researchanddesire/OSSM/README.md

# OSSM

A fresh home for the Research and Desire OSSM hardware designs.

The starting design is Lucy Chapar's motor control harness. Mechanical CAD and
PCB designs will be added as they are developed and reviewed. There is no
complete machine design or firmware release in this baseline.

To build an OSSM, follow the [build guides](hardware/build-guides/).

## Repository layout

| Folder | Contents |
| --- | --- |
| [`hardware/cables/`](hardware/cables/) | Motor control harness source and reference images |
| [`hardware/cad/`](hardware/cad/) | New mechanical design sources and STEP exports |
| [`hardware/pcb/`](hardware/pcb/) | New PCB projects, schematics, and local libraries |
| [`hardware/build-guides/`](hardware/build-guides/) | PDF build guides for the stand, actuator, wiring and wired remote |
| [`assembly-docs/`](assembly-docs/) | Assembly documentation developed alongside these designs |
| [`software/firmware/`](software/firmware/) | PlatformIO firmware project |
| [`software/scripts/`](software/scripts/) | Release, screen capture, rig and cable rendering tooling |
| [`software/dev/`](software/dev/) | Local development services |

## Render the cable

Install Python 3 and Graphviz, then run:

```sh
python3 -m venv .venv
. .venv/bin/activate
python -m pip install -r software/scripts/requirements-cables.txt
bash software/scripts/render-cables.sh
```

The command writes the diagram, PDF, HTML, and cable BOM to `cable-export/`.
CI updates the diagram shown in [`hardware/cables/README.md`](hardware/cables/README.md).
PDF, SVG, HTML, and detailed cable BOM exports are available from the
[Render Cable Harnesses workflow](https://github.com/researchanddesire/OSSM/actions/workflows/render-cables.yml).

## License

Hardware designs use [CERN-OHL-S v2](LICENSES/CERN-OHL-S-2.0.txt).
