researchanddesire/OSSM/hardware/cad/README.md

# OSSM CAD

STEP component exports for the parts in [the hardware BOM](../bom.csv).

- `actuator/`: body, belt clamps, tensioner and jam nut.
- `stand/`: PCB enclosure, PitClamp components, pivot plates, handle spacer, feet and extrusion end caps.

Most STEP files use millimetres; the PCB mount base and lid use metres.
Pivot plate 1 is the right plate; plate 2 is the left plate.
The upper-and-handle BOM entry links to both component files.
