researchanddesire/OSSM/hardware/pcb/README.md

# PCB design

New OSSM PCB projects belong here. No PCB design has been added to this rebuild
yet.

Keep editable schematics and board files with their project-local libraries and
models. Record the design application and revision. Add fabrication exports
only for the corresponding reviewed board revision.
