researchanddesire/OSSM/hardware/cad/remote/README.md

# Wired remote

| Part | Quantity per remote | STEP model |
| --- | ---: | --- |
| Body | 1 | [body.step](body.step) |
| Top cover | 1 | – |
| Knob | 2 | [knob.step](knob.step) |

These are the printed components of the complete wired remote assembly in the
[product BOM](../../bom.csv). Its Ethernet cable and two M4x8 screws are already
listed as included accessories. The [remote PCB source](../../pcb/remote/remote.sch)
is separate.
