researchanddesire/OSSM/hardware/cad/stand/README.md

# PitClamp upper and handle

The BOM's “PitClamp v1.1 Upper + Handle” entry contains one of each:

- [Upper v1.1](pitclamp-upper-v1.1.step)
- [Handle](pitclamp-handle.step)
