researchanddesire/OSSM/developer-docs/docs/hardware/specs.md

# OSSM Specs

Here you'll find an overview of the OSSM's device specifications.

## Performance

- Maximum linear speed - 1m/s
- Maximum strokes per minute - 165
- Maximum push force - 20kg
- Maximum toy weight - 1.1kg

## Dimensions

- Collapsed - 56x29x16cm
- Upright - 56x29x58cm
- Stroke length - 18cm
- Rail length - 35cm

## Electrical

- Operating voltage - 24V DC
- Current draw - 4A
- Idle power - 1-5W
- Average power - 30W
- Peak power - 95W

!!! warning "We caution against using third party power supplies as their use may short the OSSM board, thus rendering the OSSM unusable, or provide insufficient operating power."

## Motor

- Speed rating - 1500rpm
- Interface - RS485
- Model - 57AIM30
