researchanddesire/OSSM/developer-docs/docs/architecture/state-machine.md

---
title: "State Machine"
description: "Understanding the OSSM firmware state machine architecture"
---

import { MermaidControls } from '/snippets/shared/mermaid-controls.jsx';

# State Machine Architecture

The OSSM firmware uses a declarative state machine to manage device behavior. This ensures predictable transitions between operating modes and prevents invalid states that could cause unexpected behavior.

## State Diagram

The following diagram shows all states and transitions in the OSSM state machine:

```mermaid
stateDiagram-v2
    direction TB

    [*] --> idle
    idle --> homing : done

    state homing {
        direction LR
        forward --> backward : done
        forward --> [*] : error
        backward --> [*] : error
    }

    homing --> menu : homed
    homing --> error : failed

    state menu {
        direction LR
        [*] --> selecting
    }

    menu --> simplePenetration : select
    menu --> strokeEngine : select
    menu --> streaming : select  
    menu --> update : select
    menu --> wifi : select
    menu --> help : select
    menu --> restart : select

    state simplePenetration {
        direction LR
        [*] --> sp_preflight
        sp_preflight --> sp_playing : done
    }
    simplePenetration --> homing : not homed
    simplePenetration --> menu : longPress

    state strokeEngine {
        direction LR
        [*] --> se_preflight
        se_preflight --> se_playing : done
        se_playing --> se_pattern : doublePress
        se_pattern --> se_playing : buttonPress
        se_playing --> se_playing : buttonPress
    }
    strokeEngine --> homing : not homed
    strokeEngine --> menu : longPress

    state streaming {
        direction LR
        [*] --> st_preflight
        st_preflight --> st_playing : done
    }
    streaming --> homing : not homed
    streaming --> menu : longPress

    state update {
        direction LR
        [*] --> checking
        checking --> updating : available
        checking --> noUpdate : current
        noUpdate --> [*] : buttonPress
        updating --> [*] : complete
    }
    update --> wifi : offline
    update --> menu : buttonPress

    state wifi {
        direction LR
        [*] --> portal
    }
    wifi --> menu : done
    wifi --> restart : longPress

    state help {
        [*] --> helpScreen
    }
    help --> menu : buttonPress

    state error {
        direction LR
        [*] --> errorScreen
        errorScreen --> errorHelp : buttonPress
        errorHelp --> [*] : buttonPress
    }

    restart --> [*]
```

## Design Overview

The state machine is implemented using [Boost.SML](https://boost-ext.github.io/sml/) (State Machine Language), a header-only C++14 library that provides a domain-specific language for defining state machines.

### Why Boost.SML?

Boost.SML was chosen for OSSM because it offers:

- **Compile-time verification** - Invalid transitions are caught at compile time, not runtime
- **Zero runtime overhead** - Performance equivalent to hand-written switch/case
- **Declarative syntax** - The transition table reads like documentation
- **Thread safety** - Built-in support for concurrent access via policies
- **Small footprint** - Single header, ~2000 lines of code, no dependencies

### Transition Table Syntax

Each row in the transition table follows this pattern:

```cpp
source_state + event [guard] / action = target_state
```

For example:

```cpp
"menu.idle"_s + buttonPress[(isOption(Menu::SimplePenetration))] = "simplePenetration"_s
```

This reads as: "When in `menu.idle` state and a `buttonPress` event occurs, if the guard `isOption(Menu::SimplePenetration)` returns true, transition to `simplePenetration` state."

!!! info
    For a complete tutorial on transition table syntax, see the [Boost.SML Tutorial](https://boost-ext.github.io/sml/tutorial.html).

## Events

Events trigger state transitions. They are simple structs defined in `Events.h` and can be dispatched from anywhere in the codebase.

| Event | Description | Typical Source |
|---|---|---|
| `ButtonPress` | Single button click | Rotary encoder button |
| `LongPress` | Button held for extended duration | Rotary encoder button (held) |
| `DoublePress` | Two rapid button clicks | Rotary encoder button |
| `Done` | Async operation completed | Homing task, preflight check |
| `Error` | Operation failed | Homing failure, stroke too short |
| `EmergencyStop` | Immediate halt required | Safety systems |
| `Home` | Request homing sequence | External command |

### Dispatching Events

Events are dispatched using the global `stateMachine` instance:

```cpp
#include "ossm/state/state.h"

// From anywhere in the codebase
stateMachine->process_event(ButtonPress{});
stateMachine->process_event(Done{});
```

The state machine is initialized at startup in [`state.cpp`](https://github.com/KinkyMakers/OSSM-hardware/blob/main/Software/src/ossm/state/state.cpp) and exposed as a global pointer.

!!! tip
    Events are defined as empty structs. The type itself carries the meaning - no data payload is needed.

## Guards

Guards are conditional checks that determine whether a transition should occur. They return `true` to allow the transition or `false` to block it.

| Guard | Description | Returns `true` when... |
|---|---|---|
| `isOnline` | Check WiFi connection | Device is connected to WiFi |
| `isUpdateAvailable` | Check for firmware updates | Server reports newer version available |
| `isStrokeTooShort` | Validate homing result | Measured stroke is below minimum threshold |
| `isOption(Menu)` | Check selected menu item | Current menu selection matches the specified option |
| `isPreflightSafe` | Validate speed knob position | Speed potentiometer is in the dead zone (safe to start) |
| `isFirstHomed` | One-time initial homing check | This is the first successful homing since boot |
| `isNotHomed` | Check homing status | Device has not been homed or homing was invalidated |

### Guard Implementation

Guards are defined as `constexpr` lambdas in the [`guards`](https://github.com/KinkyMakers/OSSM-hardware/blob/main/Software/src/ossm/state/guards.h) namespace. They call forward-declared implementation functions to keep the header lightweight:

```cpp
// In guards.h - forward declaration
bool ossmIsPreflightSafe();

namespace guards {
    // Constexpr lambda wraps the implementation
    constexpr auto isPreflightSafe = []() { 
        return ossmIsPreflightSafe(); 
    };

    // Parameterized guard using nested lambda
    constexpr auto isOption = [](Menu option) {
        return [option]() { return ossmGetMenuOption() == option; };
    };
}
```

The actual logic lives in `guards.cpp`, keeping compile times fast and allowing implementation changes without recompiling the transition table.

!!! info
    For more on guard patterns, see the [Boost.SML Guards documentation](https://boost-ext.github.io/sml/user-guide.html#guards).

## Actions

Actions are functions executed during state transitions. They perform side effects like updating the display, starting motors, or resetting settings.

### Display Actions

| Action | Description |
|---|---|
| `drawHello` | Show welcome/boot screen |
| `drawMenu` | Render the main menu |
| `drawPlayControls` | Show speed/stroke/depth controls |
| `drawPatternControls` | Show pattern selection UI |
| `drawPreflight` | Show "reduce speed to start" warning |
| `drawHelp` | Display help/support information |
| `drawWiFi` | Show WiFi configuration screen |
| `drawUpdate` | Show "checking for updates" screen |
| `drawNoUpdate` | Show "firmware is up to date" message |
| `drawUpdating` | Show update progress |
| `drawError` | Display error state with message |

### Motion Actions

| Action | Description |
|---|---|
| `startHoming` | Begin the homing sequence |
| `clearHoming` | Reset homing state variables |
| `startSimplePenetration` | Start Simple Penetration mode task |
| `startStrokeEngine` | Start Stroke Engine mode task |
| `startStreaming` | Start Streaming mode task |
| `emergencyStop` | Force stop motor and disable outputs |

### Settings Actions

| Action | Description |
|---|---|
| `resetSettingsStrokeEngine` | Initialize defaults for Stroke Engine (speed=0, stroke=50, depth=10, sensation=50) |
| `resetSettingsSimplePen` | Initialize defaults for Simple Penetration (speed=0, stroke=0, depth=50) |
| `incrementControl` | Cycle through control parameters (stroke → depth → sensation) |
| `setHomed` | Mark device as successfully homed |
| `setNotHomed` | Invalidate homing (requires re-home before play) |

### System Actions

| Action | Description |
|---|---|
| `restart` | Restart the ESP32 |
| `resetWiFi` | Clear saved WiFi credentials |
| `updateOSSM` | Download and install firmware update |

### Action Implementation

Actions are defined as `constexpr` lambdas in the [`actions`](https://github.com/KinkyMakers/OSSM-hardware/blob/main/Software/src/ossm/state/actions.h) namespace. Like guards, they delegate to forward-declared implementation functions:

```cpp
// In actions.h - forward declarations
void ossmDrawHello();
void ossmEmergencyStop();

namespace actions {
    constexpr auto drawHello = []() { ossmDrawHello(); };
    constexpr auto emergencyStop = []() { ossmEmergencyStop(); };
}
```

The implementation functions in `actions.cpp` call into the appropriate feature modules:

```cpp
// In actions.cpp
void ossmEmergencyStop() {
    stepper->forceStop();
    stepper->disableOutputs();
}

void ossmDrawHello() {
    pages::drawHello();  // Delegates to pages namespace
}
```

This pattern keeps the state machine decoupled from specific implementations and allows feature modules to be developed independently.

!!! warning
    Actions must not block the main thread. Long-running operations should spawn FreeRTOS tasks instead.

!!! info
    For more on action patterns, see the [Boost.SML Actions documentation](https://boost-ext.github.io/sml/user-guide.html#actions).

## Thread Safety

The OSSM state machine is configured with thread-safe policies to handle events from multiple FreeRTOS tasks:

```cpp
sml::sm<OSSMStateMachine, sml::thread_safe<ESP32RecursiveMutex>, sml::logger<StateLogger>>
```

This uses a recursive mutex to protect state transitions, allowing safe event dispatch from:

- The main loop
- Button interrupt handlers
- BLE command handlers
- Background tasks

The state machine is initialized in [`state.cpp`](https://github.com/KinkyMakers/OSSM-hardware/blob/main/Software/src/ossm/state/state.cpp):

```cpp
// Global state machine instance
StateMachine* stateMachine = nullptr;

void initStateMachine() {
    stateMachine = new StateMachine{};
    stateMachine->process_event(Done{});  // Trigger initial transition
}
```

!!! info
    For more on thread safety policies, see the [Boost.SML Policies documentation](https://boost-ext.github.io/sml/user-guide.html#policies).

## State Logging

The firmware includes a `StateLogger` that logs all state transitions for debugging:

```cpp
sml::logger<StateLogger>
```

This outputs transition information via ESP-IDF logging, making it easy to trace state machine behavior during development.

## Architecture Notes

The state machine follows a **decoupled modular architecture**:

- **State machine definition** ([`machine.h`](https://github.com/KinkyMakers/OSSM-hardware/blob/main/Software/src/ossm/state/machine.h)) contains only the transition table
- **Actions and guards** are `constexpr` lambdas that delegate to implementation functions
- **Feature modules** (like `pages::`, `simple_penetration::`, `stroke_engine::`) contain the actual logic
- **Global state structs** manage application state instead of class members

!!! note
    The `OSSM` class in `ossm/OSSM.h` is retained for backward compatibility with BLE command handling. New features should use stateless namespace functions that operate on global state.

For a complete overview of the source code organization, see [Folder Structure](/ossm/architecture/folder-structure).

## Further Reading

- **[Folder Structure](/ossm/architecture/folder-structure)** — Understand the source code organization and design philosophy.

- **[Boost.SML Tutorial](https://boost-ext.github.io/sml/tutorial.html)** — Step-by-step guide to building state machines with Boost.SML.

- **[Boost.SML User Guide](https://boost-ext.github.io/sml/user-guide.html)** — Complete reference for all Boost.SML features.

- **[Operating Modes](/ossm/getting-started/operating-modes)** — Learn about Simple Penetration, Stroke Engine, and Streaming modes.
