researchanddesire/OSSM/hardware/cables/images/F_24V.png

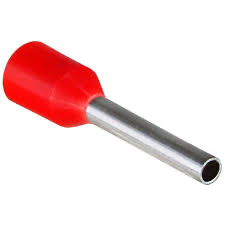
hardware/cables/images/F_24V.png
