researchanddesire/OSSM/hardware/cables/images/F_GND.png

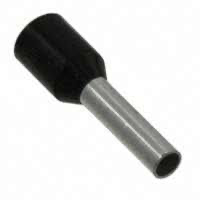
hardware/cables/images/F_GND.png
