researchanddesire/OSSM/hardware/cables/images/JST_PHR-04.png

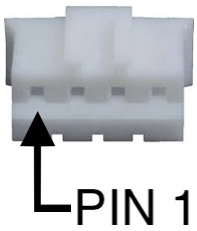
hardware/cables/images/JST_PHR-04.png
