researchanddesire/OSSM/hardware/cables/images/OSSM_Harness.png

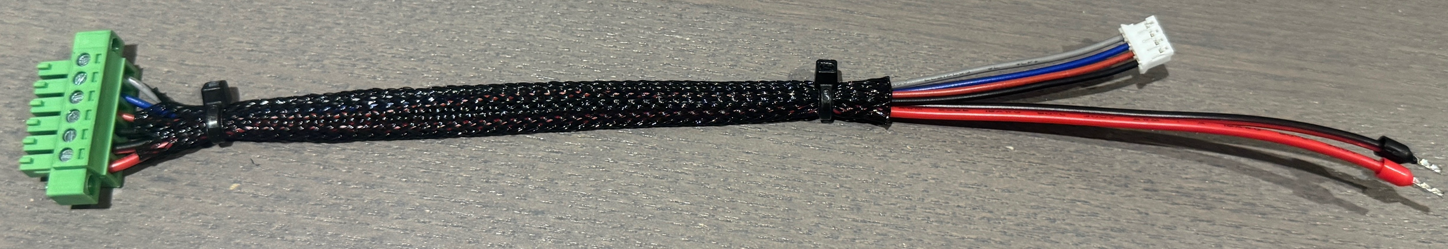
hardware/cables/images/OSSM_Harness.png
