researchanddesire/OSSM/hardware/cables/images/TB_1.png

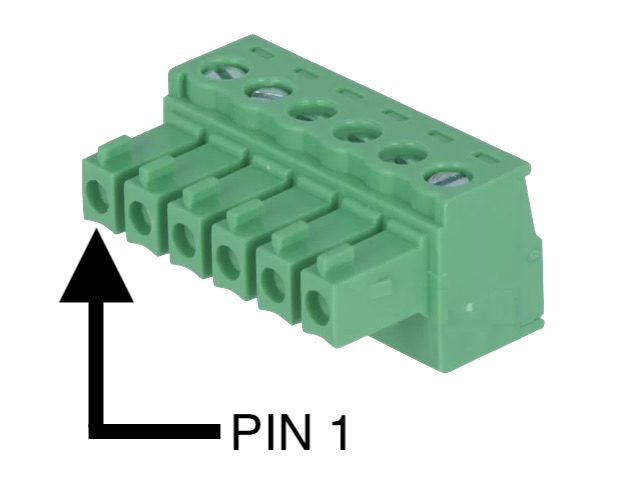
hardware/cables/images/TB_1.png
