researchanddesire/OSSM/assembly-docs/bom.mdx

---
title: Bill of Materials
---

import { OssmBomTable } from "./_bom/table";

<style>{'#nd-page > aside[aria-label="Product safety"] { display: none; }'}</style>

Parts for one OSSM with extrusion stand and wired remote, grouped by category. Quantities include spares.

<OssmBomTable />
