researchanddesire/OSSM/developer-docs/docs/hardware/bom.md

# OSSM Bill of Materials

Below you'll find a list of everything you need to build your OSSM Ready-to-Play! Hover over a component name with your cursor to view a photo of it. Please note that the bracketed numbers denote quantity.

**Fasteners & Hardware**

Electronics board + related:

- OSSM PCB (1)
- Wired Remote (1)
- Ethernet cable (1)
- M4x8mm buttonhead screw (2)
- Wireless Remote (1)
- USB-C charging cable for Wireless Remote (1)

!!! info "The Ethernet cable and M4x8mm buttonhead screws come with the Wired Remote, while the USB-C charging cable comes with the Wireless Remote."

M3:

- M3x8mm screw (18)
- M3x20mm screw (3)
- M3 nut (10)

M4:

- M4x25mm screw (2)
- M4 nut (3)

M5:

- M5x20 mm screw (6)
- M5x35mm screw (4)
- M5 nut (8)

M6:

- M6x12mm screw (14)
- M6x16mm screw (2)
- M6x25mm screw (6)
- M6x25mm clamping lever (2)
- M6 washer (16)
- M6 T-nut (26)

Other hardware:

- Base brackets (4)
- Grippy feet (4)
- Rubber washers (2)
- End caps (6)
- Sandbag (1)
- Bearings (6)
- Belt (1)
- Pulley (1)
- Linear rail (1)
- Motor (1)
- Wire harness (1)
- Power supply unit (1)
- USB-C adapter (1)

Extrusion pieces:

- 12" 3030 extrusion (2)
- 18" 3030 extrusion (1)
- 19" 3030 extrusion (1)

**Printed parts**

- Middle body (1)
- Lower body (1)
- Body cover (1)
- Pivot plate no. 1 (1)
- Pivot plate no. 2 (1)
- Handle spacer (8)
- Printed foot (4)
- T-nut support (2)
- Belt clamp tensioner (1)
- Belt clamp top (1)
- Belt clamp bottom (1)
- Jam nut (1)
- PCB enclosure base (1)
- PCB enclosure lid (1)
- PitClamp lower standard (1)
- PitClamp upper standard (1)
- PitClamp hex dogbone (1)
- PitClamp round dogbone (1)
- PitClamp 57AIM motor ring (1)
