researchanddesire/OSSM/hardware/bom.csv

# | Part Name | Category | Description | Qty | UOM | Manufacturer | MFG PN | Vendor | Vendor PN | Design Source | Purchase Source | Notes
1 | Wired OSSM Remote | ASM | Wired remote control assembly | 1 | each | R+D | – | R+D | – | cad/remote/README.md | https://www.researchanddesire.com/products/ossm-reference-board | Electronics.
2 | 8mm bore 20T pulley | BTP | GT2 timing pulley, 20 teeth, 8 mm bore, 10 mm belt width | 1 | each | Generic Factory | – | AliExpress | 20T W10 B8 | – | https://www.aliexpress.com/item/32781681772.html | Actuator.
3 | GT2 Belt | BTP | GT2 timing belt, 10 mm width | 0.5 | m | Generic Factory | – | AliExpress | 10M-10MM-2GT | – | https://www.aliexpress.com/item/32952396111.html | Actuator.
4 | Remote Ethernet Cable | CBL | Ethernet cable connecting the wired remote to the controller | 1 | each | Generic Factory | – | R+D | – | – | https://www.researchanddesire.com/products/ossm-remote-pcb-only | Electronics. Included with wired remote.
5 | Motor Control Harness | CHA | Motor terminal block to controller JST PH connection with power ferrules | 1 | each | R+D | – | R+D | – | cables/OSSM-Motor-Control-Harness.yml | – | Electronics.
6 | 12" Extrusion | EXT | 12 in long, 30 x 30 mm T-slot aluminum extrusion, black anodized | 2 | each | Generic Factory | – | Fazstore | 30QE3030 | – | https://www.fazstore.ca/product/30qe3030-black/ | Extrusion stand.
7 | 18" Extrusion | EXT | 18 in long, 30 x 30 mm T-slot aluminum extrusion, black anodized | 1 | each | Generic Factory | – | Fazstore | 30QE3030 | – | https://www.fazstore.ca/product/30qe3030-black/ | Extrusion stand.
8 | 19.5" Extrusion | EXT | 19.5 in long, 30 x 30 mm T-slot aluminum extrusion, black anodized | 1 | each | Generic Factory | – | Fazstore | 30QE3030 | – | https://www.fazstore.ca/product/30qe3030-black/ | Extrusion stand.
9 | Base Brackets | FBO | Base bracket for 3030 extrusion | 4 | each | Generic Factory | – | AliExpress | 3030 | – | https://www.aliexpress.com/item/1005004878958579.html | Extrusion stand. Bag 3.
10 | Grippy Feet | FBO | Grippy foot | 4 | each | Generic Factory | – | Amazon | CB150 | – | https://www.amazon.ca/dp/B08C2WMP7G | Extrusion stand. Bag 3.
11 | OSSM - Body - MIDDLE | FDM | FDM-printed OSSM - Body - MIDDLE | 1 | each | R+D | OSSM MIDDLE BODY | R+D | – | cad/actuator/body-middle.step | https://www.researchanddesire.com/products/ossm-3d-printed-part-kit | Actuator.
12 | OSSM - Body - Lower | FDM | FDM-printed OSSM - Body - Lower | 1 | each | R+D | OSSM MAIN BODY | R+D | – | cad/actuator/body-lower.step | https://www.researchanddesire.com/products/ossm-3d-printed-part-kit | Actuator.
13 | OSSM - Belt Clamp - Tensioner | FDM | FDM-printed OSSM - Belt Clamp - Tensioner | 1 | each | R+D | TENSIONER | R+D | – | cad/actuator/belt-tensioner.step | – | Actuator.
14 | OSSM - Belt Clamp - Top | FDM | FDM-printed OSSM - Belt Clamp - Top | 1 | each | R+D | CLAMP 1 | R+D | – | cad/actuator/belt-clamp-top.step | – | Actuator.
15 | OSSM - Belt Clamp - Bottom | FDM | FDM-printed OSSM - Belt Clamp - Bottom | 1 | each | R+D | CLAMP 2 | R+D | – | cad/actuator/belt-clamp-bottom.step | – | Actuator.
16 | OSSM - Body - Cover | FDM | FDM-printed OSSM - Body - Cover | 1 | each | R+D | COVER | R+D | – | cad/actuator/body-cover.step | https://www.researchanddesire.com/products/ossm-3d-printed-part-kit | Actuator.
17 | OSSM - 24mm Jam Nut | FDM | FDM-printed OSSM - 24mm Jam Nut | 1 | each | R+D | JAM NUT | R+D | – | cad/actuator/24mm-jam-nut.step | https://www.researchanddesire.com/products/ossm-3d-printed-part-kit | Actuator.
18 | OSSM - PCB Mount Base | FDM | FDM-printed OSSM - PCB Mount Base | 1 | each | R+D | PCB MOUNT BASE | R+D | – | cad/stand/pcb-mount-base.step | https://www.researchanddesire.com/products/ossm-3d-printed-part-kit | Actuator.
19 | OSSM - PCB Mount Lid | FDM | FDM-printed OSSM - PCB Mount Lid | 1 | each | R+D | PCB MOUNT LID | R+D | – | cad/stand/pcb-mount-lid.step | https://www.researchanddesire.com/products/ossm-3d-printed-part-kit | Actuator.
20 | 57AIM Ring v1.1 | FDM | FDM-printed 57AIM Ring v1.1 | 1 | each | R+D | PITCLAMP RING V1.1 | R+D | – | cad/stand/57aim-ring-v1.1.step | https://www.researchanddesire.com/products/ossm-3d-printed-part-kit | Actuator.
21 | PitClamp v1.1 Lower Standard | FDM | FDM-printed PitClamp v1.1 Lower Standard | 1 | each | R+D | PITCLAMP LOWER | R+D | – | cad/stand/pitclamp-lower-v1.1.step | https://www.researchanddesire.com/products/ossm-3d-printed-part-kit | Actuator.
22 | PitClamp v1.1 Upper + Handle | FDM | FDM-printed PitClamp v1.1 Upper + Handle | 1 | each | R+D | PITCLAMP UPPER | R+D | – | cad/stand/README.md | https://www.researchanddesire.com/products/ossm-3d-printed-part-kit | Actuator.
23 | PitClamp Dogbones Hex | FDM | FDM-printed PitClamp Dogbones Hex | 1 | each | R+D | PIT DOGBONE 1 | R+D | – | cad/stand/pitclamp-dogbone-hex.step | https://www.researchanddesire.com/products/ossm-3d-printed-part-kit | Actuator.
24 | PitClamp Dogbones Round | FDM | FDM-printed PitClamp Dogbones Round | 1 | each | R+D | PIT DOGBONE 2 | R+D | – | cad/stand/pitclamp-dogbone-round.step | https://www.researchanddesire.com/products/ossm-3d-printed-part-kit | Actuator.
25 | OSSM Pivot Plate 1 | FDM | FDM-printed OSSM Pivot Plate 1 | 1 | each | R+D | – | R+D | – | cad/stand/pivot-plate-1.step | – | Extrusion stand.
26 | OSSM Pivot Plate 2 | FDM | FDM-printed OSSM Pivot Plate 2 | 1 | each | R+D | – | R+D | – | cad/stand/pivot-plate-2.step | – | Extrusion stand.
27 | OSSM Handle Spacer | FDM | FDM-printed OSSM Handle Spacer | 8 | each | R+D | – | R+D | – | cad/stand/handle-spacer.step | – | Extrusion stand.
28 | OSSM Foot | FDM | FDM-printed OSSM Foot | 4 | each | R+D | – | R+D | – | cad/stand/foot.step | – | Extrusion stand.
29 | OSSM T Nut Support | FDM | FDM-printed OSSM T Nut Support | 2 | each | R+D | – | R+D | – | – | – | Optional. Used in Ready-to-Play builds.
30 | End caps | FDM | FDM-printed extrusion end cap | 6 | each | R+D | – | R+D | – | cad/stand/end-cap.step | – | Extrusion stand. Bag 3.
31 | OSSM - 24mm Rail Adapter | FDM | Rail-to-24 mm thread end effector | 1 | each | R+D | – | R+D | – | cad/actuator/24mm-rail-adapter.step | https://www.researchanddesire.com/products/ossm-3d-printed-part-kit | Actuator. Included in the printed parts kit.
32 | OSSM - Double Double | FDM | 24 mm threaded Double Double toy mount | 1 | each | R+D | – | R+D | – | – | https://www.researchanddesire.com/products/ossm-3d-printed-part-kit | Actuator. Included in the printed parts kit.
33 | OSSM - Flange Base | FDM | 24 mm threaded flange base | 1 | each | R+D | – | R+D | – | cad/end-effectors/flange-base.step | https://www.researchanddesire.com/products/ossm-3d-printed-part-kit | Actuator. Included in the printed parts kit.
34 | OSSM - Flange Ring 50mm | FDM | 2 in (50 mm) flange ring | 1 | each | R+D | – | R+D | – | cad/end-effectors/flange-ring-50mm.step | https://www.researchanddesire.com/products/ossm-3d-printed-part-kit | Actuator. Included in the printed parts kit.
35 | OSSM - Flange Ring 63mm | FDM | 2.5 in (63 mm) flange ring | 1 | each | R+D | – | R+D | – | cad/end-effectors/flange-ring-63mm.step | https://www.researchanddesire.com/products/ossm-3d-printed-part-kit | Actuator. Included in the printed parts kit.
36 | M3x8mm | FST | ISO 4762 — M3x8 hexagon socket head cap screw | 18 | each | Generic Factory | – | Bolt Depot | 13635 | – | https://boltdepot.com/Product-Details?product=13635 | Actuator. Includes 2 spares. Black oxide. Screw property class 12.9.
37 | M3x20mm | FST | ISO 4762 — M3x20 hexagon socket head cap screw | 3 | each | Generic Factory | – | Bolt Depot | 13639 | – | https://boltdepot.com/Product-Details?product=13639 | Actuator. Includes 1 spare. Black oxide. Screw property class 12.9.
38 | M3 Nuts | FST | ISO 4032 — M3 hexagon regular nut (style 1) | 10 | each | Generic Factory | – | Bolt Depot | 4773 | – | https://boltdepot.com/Product-Details?product=4773 | Actuator. Black oxide.
39 | M4x25mm | FST | ISO 4762 — M4x25 hexagon socket head cap screw | 2 | each | Generic Factory | – | Bolt Depot | 6511 | – | https://boltdepot.com/Product-Details?product=6511 | Actuator. Black oxide. Screw property class 12.9.
40 | M4 Nuts | FST | ISO 4032 — M4 hexagon regular nut (style 1) | 3 | each | Generic Factory | – | Bolt Depot | 4774 | – | https://boltdepot.com/Product-Details?product=4774 | Actuator. Black oxide.
41 | M5x20mm Caphead screws | FST | ISO 4762 — M5x20 hexagon socket head cap screw | 6 | each | Generic Factory | – | Bolt Depot | 6523 | – | https://boltdepot.com/Product-Details?product=6523 | Actuator. Black oxide. Screw property class 12.9.
42 | M5x35mm | FST | ISO 4762 — M5x35 hexagon socket head cap screw | 4 | each | Generic Factory | – | Bolt Depot | 6526 | – | https://boltdepot.com/Product-Details?product=6526 | Actuator. Black oxide. Screw property class 12.9.
43 | M5 Nuts | FST | ISO 4032 — M5 hexagon regular nut (style 1) | 8 | each | Generic Factory | – | Bolt Depot | 4775 | – | https://boltdepot.com/Product-Details?product=4775 | Actuator. Includes 2 spares. Black oxide.
44 | M6x16mm | FST | ISO 4762 — M6x16 hexagon socket head cap screw | 2 | each | Generic Factory | – | Bolt Depot | 6539 | – | https://boltdepot.com/Product-Details?product=6539 | Actuator. Black oxide. Screw property class 12.9.
45 | M6 T nut | FST | ISO 299 — M6 T-nut for 3030 extrusion | 2 | each | Generic Factory | – | AliExpress | 30S-M6 | – | https://www.aliexpress.com/item/1005001714123635.html | Actuator. Black oxide. Property class 12.9.
46 | M6x12 Screw | FST | ISO 4762 — M6x12 hexagon socket head cap screw | 14 | each | Generic Factory | – | Bolt Depot | 6537 | – | https://boltdepot.com/Product-Details?product=6537 | Extrusion stand. Bag 1. Black oxide. Screw property class 12.9.
47 | M6x25 Screw | FST | ISO 4762 — M6x25 hexagon socket head cap screw | 6 | each | Generic Factory | – | Bolt Depot | 6541 | – | https://boltdepot.com/Product-Details?product=6541 | Extrusion stand. Bag 1. Black oxide. Screw property class 12.9.
48 | M6 Washer | FST | ISO 7089 — M6 plain washer, normal series, product grade A | 16 | each | Generic Factory | – | Bolt Depot | 4516 | – | https://boltdepot.com/Product-Details?product=4516 | Extrusion stand. Bag 1. Black oxide.
49 | M6 T-Nuts | FST | ISO 299 — M6 T-nut for 3030 extrusion | 24 | each | Generic Factory | – | AliExpress | 30S-M6 | – | https://www.aliexpress.com/item/1005001714123635.html | Extrusion stand. Bag 1. Black oxide. Property class 12.9.
50 | M6x25mm Handle | FST | M6x25mm Handle | 2 | each | Generic Factory | – | AliExpress | M6x50x25 | – | https://www.aliexpress.com/item/1005005417338944.html | Extrusion stand. Bag 2.
51 | Rubber Washer | FST | Rubber washer | 2 | each | Generic Factory | – | McMaster | 90131A603 | – | https://www.mcmaster.com/catalog/130/3689/90131A603 | Extrusion stand. Bag 3.
52 | M4x8mm Buttonhead Screws | FST | M4x8 buttonhead screws for the wired remote | 2 | each | Generic Factory | – | R+D | – | – | https://www.researchanddesire.com/products/ossm-remote-pcb-only | Electronics. Included with wired remote.
53 | 5x11x4mm Bearings | LNM | 5 x 11 x 4 mm sealed bearing | 6 | each | Generic Factory | MR115-2RS | AliExpress | MR115-2RS | – | https://www.aliexpress.com/item/1005004734688651.html | Actuator.
54 | 350mm Linear Rail | LNM | 350 mm MGN12 linear rail with one carriage | 1 | each | Generic Factory | – | Robotdigg | GS_MGN12-1H-350CH | – | https://www.robotdigg.com/product/1820/ | Actuator.
55 | Gold Motor | MTR | NEMA 23 integrated servo motor, gold finish | 1 | each | Generic Factory | 57AIM30 | Robotdigg | 57AIM30 | – | https://www.robotdigg.com/product/1690/BLDC-Servo-Motor-with-CANBus-or-RS485-driver-NEMA23 | Actuator.
56 | OSSM Controller PCBA | PCA | Assembled ESP32 controller board, revision 2.3, 24 V input | 1 | each | R+D | – | R+D | – | pcb/controller/OSSM_rev2_3.dip | https://www.researchanddesire.com/products/ossm-reference-board | Electronics.
57 | 3x3" bags (M6 Bolts, M6 Washers + T-Nuts, M6 Handles, M5 Fasteners, Rubber Washers + Feet) | PKG | 3x3" bags (M6 Bolts, M6 Washers + T-Nuts, M6 Handles, M5 Fasteners, Rubber Washers + Feet) | 5 | each | Generic Factory | – | Uline | S-1692 | – | https://www.uline.ca/Product/Detail/S-1692/Reclosable-Poly-Bags/3-x-3-2-Mil-Reclosable-Bags | Extrusion stand.
58 | 6x8" bag (3x3" bags + End caps + Base brackets) | PKG | 6x8" bag (3x3" bags + End caps + Base brackets) | 1 | each | Generic Factory | – | Uline | S-5065 | – | https://www.uline.ca/Product/Detail/S-5065/Resealable-Bags/6-x-8-15-Mil-Resealable-Bags | Extrusion stand.
59 | 6x12" bags (All printed parts) | PKG | 6x12" bags (All printed parts) | 2 | each | Generic Factory | – | Uline | S-20313 | – | https://www.uline.ca/Product/Detail/S-20313/Resealable-Bags/6-x-12-15-Mil-Resealable-Bags | Extrusion stand.
60 | 20x6x6" Cardboard box | PKG | 20x6x6" Cardboard box | 1 | each | Generic Factory | – | Uline | S-4639 | – | https://www.uline.ca/Product/Detail/S-4639/Corrugated-Boxes-200-Test/20-x-6-x-6-Long-Corrugated-Boxes | Extrusion stand.
61 | 24V Power Supply | PSU | 24 V DC power supply, 5 A continuous output | 1 | each | Generic Factory | – | R+D | – | – | https://www.researchanddesire.com/products/ossm-24v-power-supply | Electronics.
