researchanddesire/OSSM/hardware/cad/end-effectors/flange-base.step

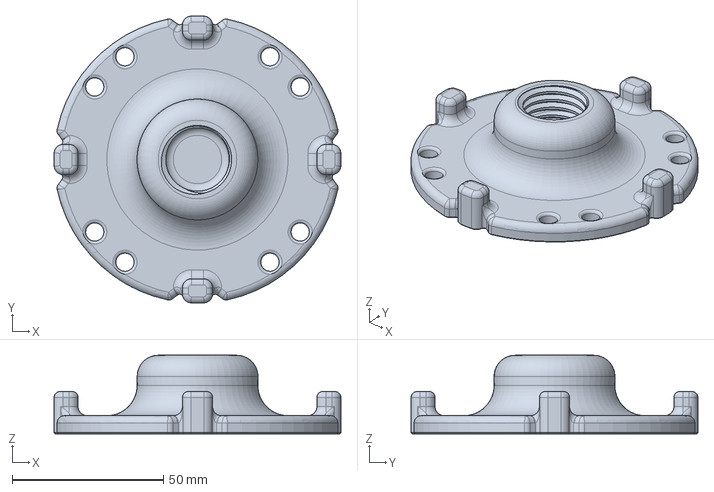
[picture p7: CAD file, 2026-10-30]
hardware/cad/end-effectors/flange-base.step
95.0 x 95.0 x 26.0 mm
