researchanddesire/OSSM/hardware/cad/remote/body.step

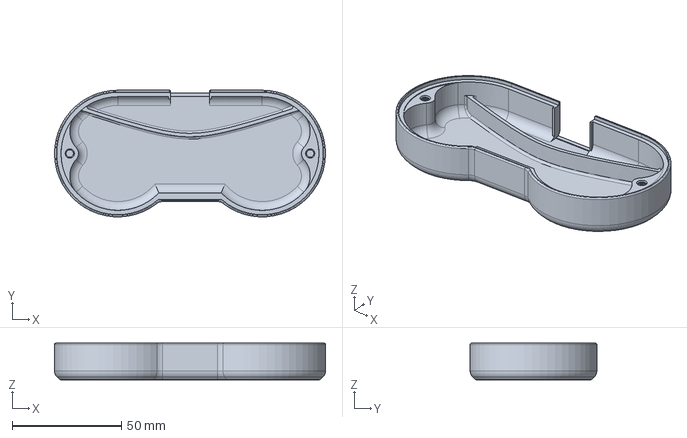
[picture p8: CAD file, 2026-10-30]
hardware/cad/remote/body.step
124.0 x 58.0 x 16.8 mm
