researchanddesire/OSSM/hardware/cad/stand/pivot-plate-2.step

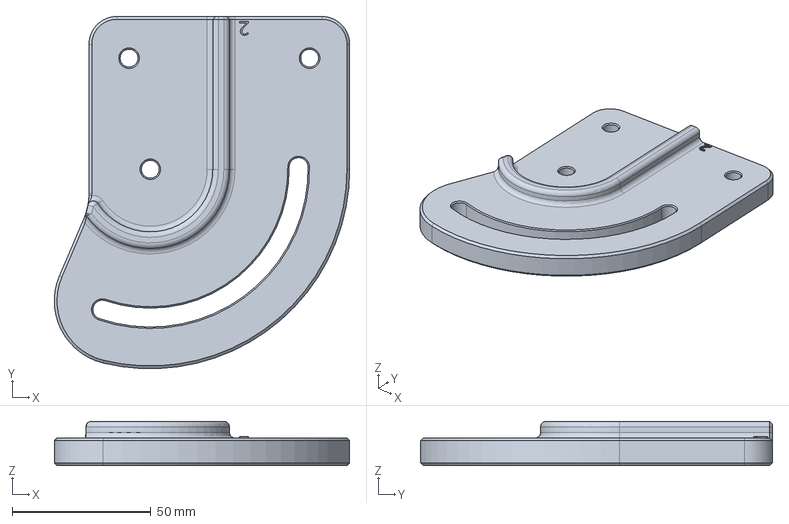
[picture p9: CAD file, 2026-10-08]
hardware/cad/stand/pivot-plate-2.step
106.4 x 126.7 x 16.0 mm
