researchanddesire/OSSM/hardware/cad/actuator/belt-clamp-bottom.step

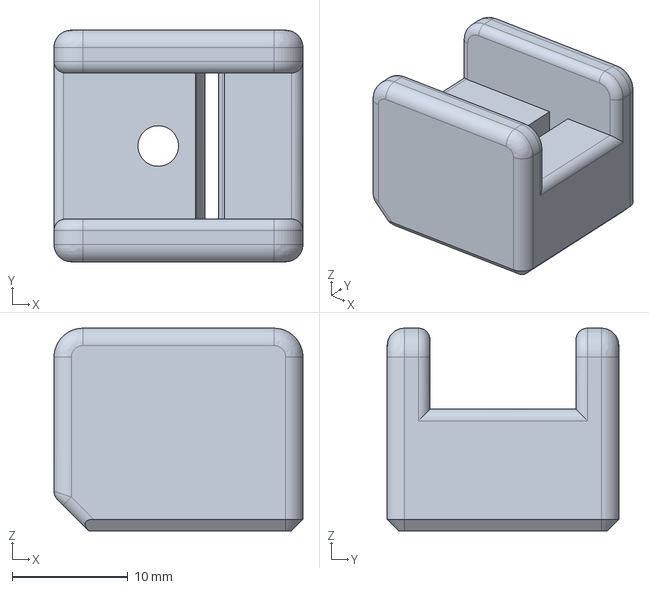
[picture p10: CAD file, 2026-10-08]
hardware/cad/actuator/belt-clamp-bottom.step
21.5 x 20.0 x 17.5 mm
