researchanddesire/OSSM/hardware/cad/remote/knob.step

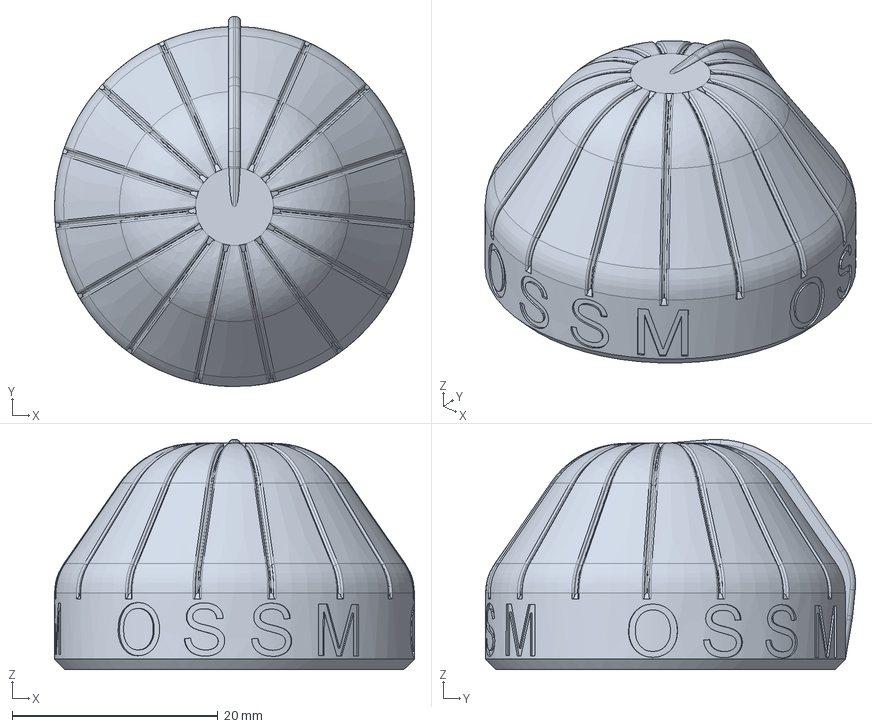
[picture p11: CAD file, 2026-10-30]
hardware/cad/remote/knob.step
35.0 x 36.0 x 22.4 mm
