researchanddesire/OSSM/hardware/cad/stand/foot.step

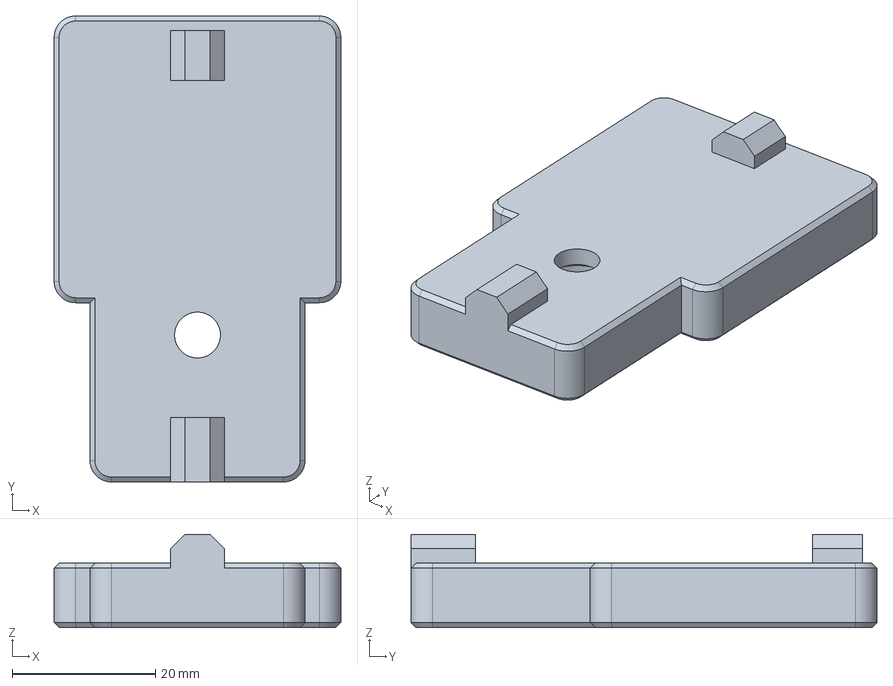
[picture p12: CAD file, 2026-10-08]
hardware/cad/stand/foot.step
40.0 x 65.0 x 13.0 mm
