researchanddesire/OSSM/hardware/cad/actuator/belt-clamp-top.step

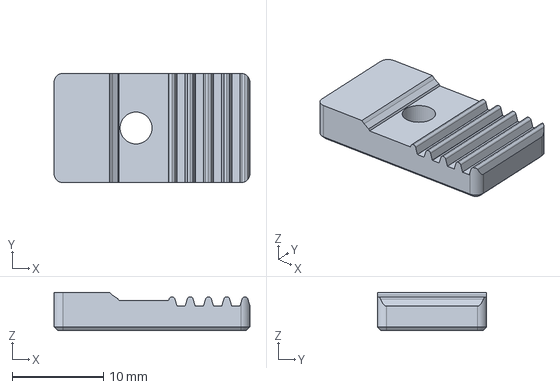
[picture p13: CAD file, 2026-10-08]
hardware/cad/actuator/belt-clamp-top.step
21.5 x 12.0 x 4.20 mm
