researchanddesire/OSSM/hardware/cad/actuator/body-cover.step

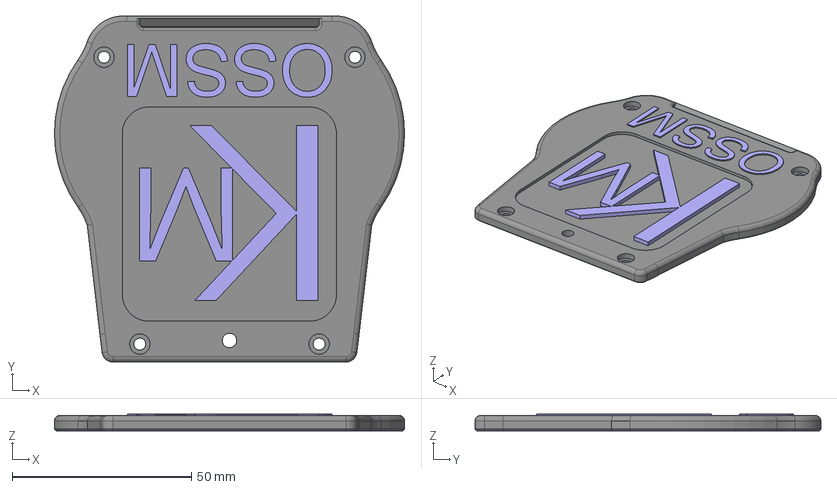
[picture p14: CAD file, 2026-10-08]
hardware/cad/actuator/body-cover.step
97.7 x 96.5 x 4.70 mm
