researchanddesire/OSSM/hardware/cad/stand/pcb-mount-base.step

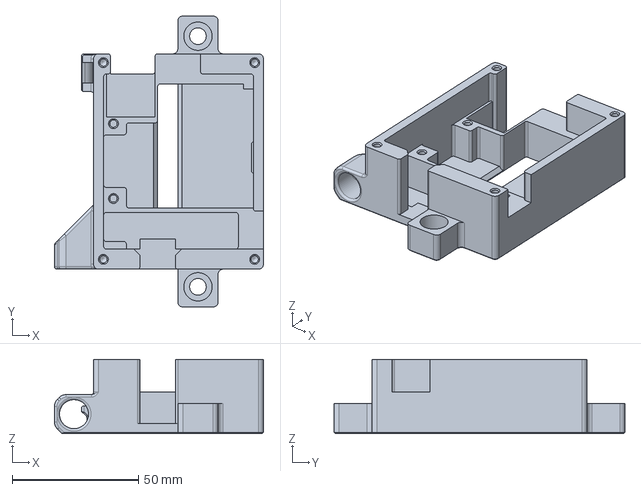
[picture p15: CAD file, 2026-10-08]
hardware/cad/stand/pcb-mount-base.step
82.9 x 115.4 x 29.5 mm
