researchanddesire/OSSM/hardware/cad/actuator/body-middle.step

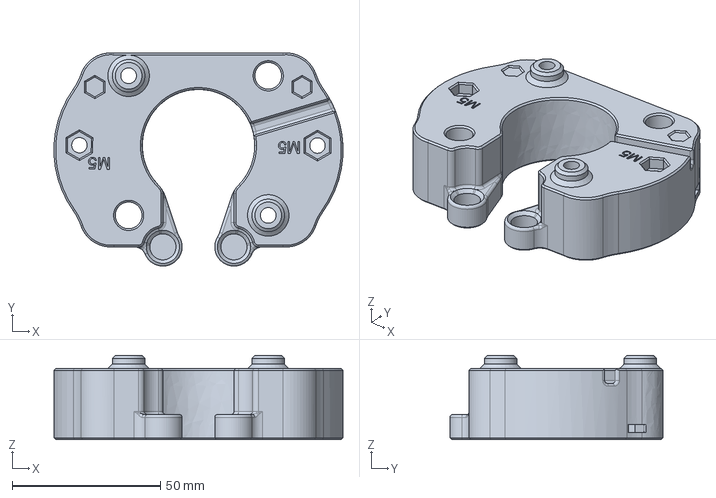
[picture p16: CAD file, 2026-10-08]
hardware/cad/actuator/body-middle.step
97.6 x 72.0 x 28.4 mm
