researchanddesire/OSSM/hardware/cad/stand/handle-spacer.step

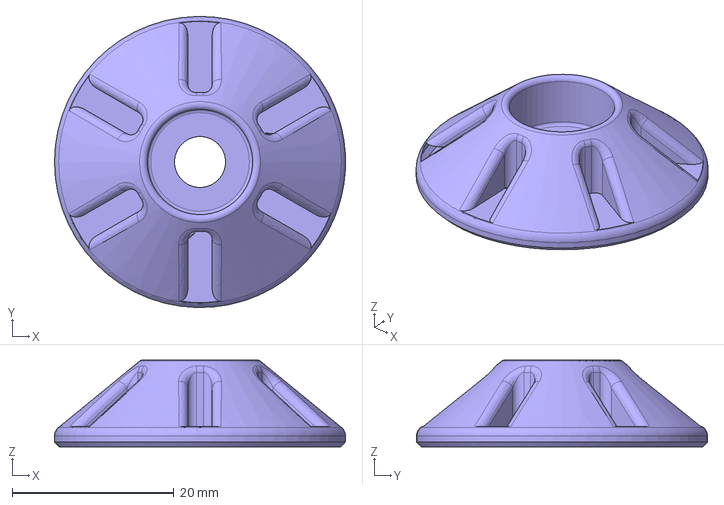
[picture p17: CAD file, 2026-10-08]
hardware/cad/stand/handle-spacer.step
36.0 x 36.0 x 10.7 mm
