researchanddesire/OSSM/hardware/cad/actuator/belt-tensioner.step

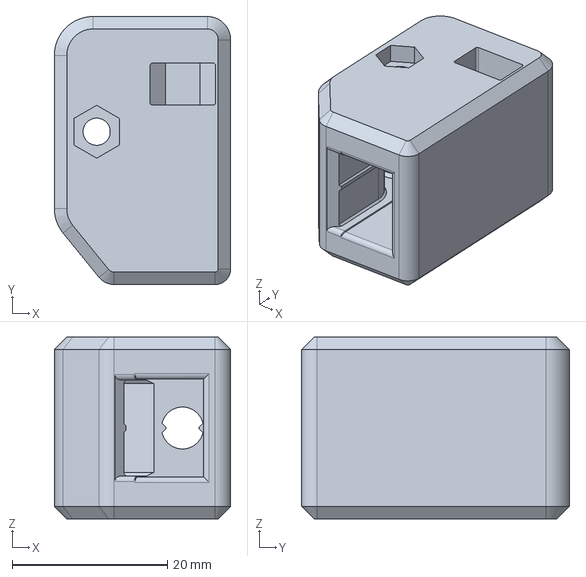
[picture p18: CAD file, 2026-10-08]
hardware/cad/actuator/belt-tensioner.step
22.7 x 34.5 x 23.4 mm
