researchanddesire/OSSM/hardware/cad/stand/pitclamp-lower-v1.1.step

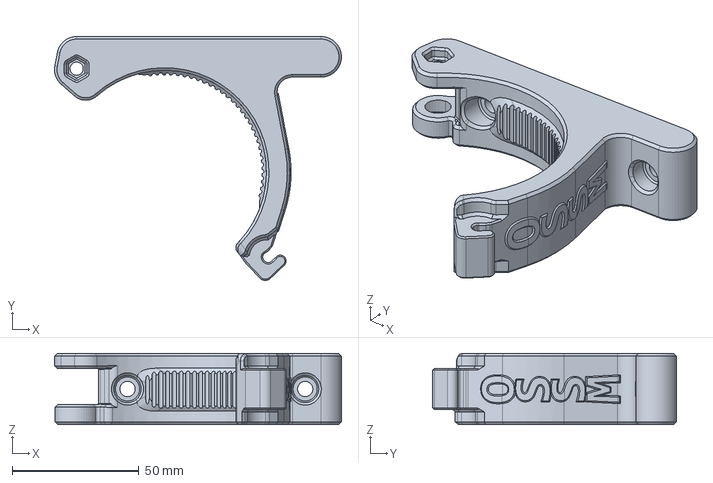
[picture p19: CAD file, 2026-10-08]
hardware/cad/stand/pitclamp-lower-v1.1.step
113.1 x 96.1 x 28.0 mm
