researchanddesire/OSSM/hardware/cad/actuator/body-lower.step

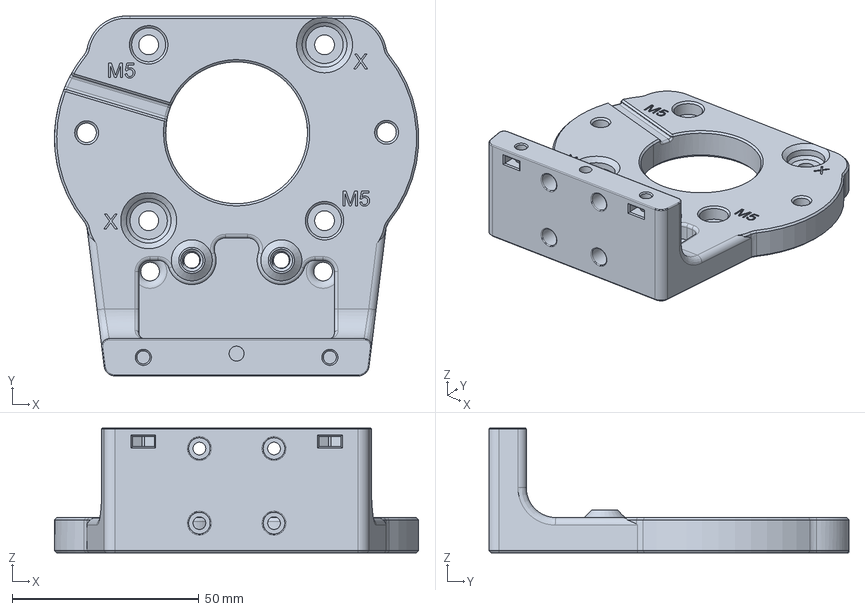
[picture p20: CAD file, 2026-10-08]
hardware/cad/actuator/body-lower.step
97.6 x 96.5 x 33.5 mm
