researchanddesire/OSSM/hardware/cad/stand/pitclamp-handle.step

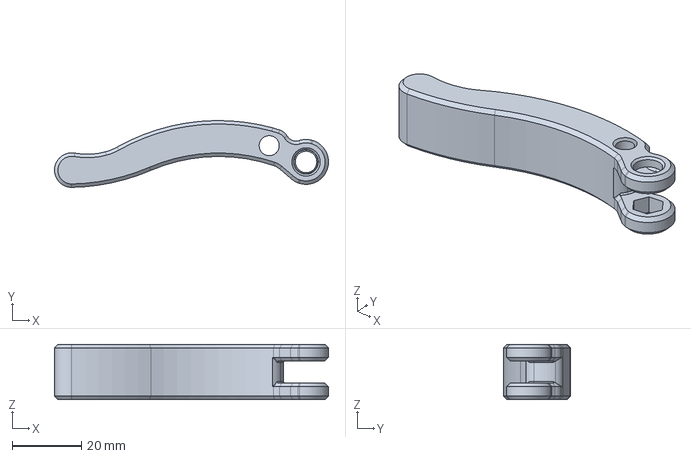
[picture p21: CAD file, 2026-10-08]
hardware/cad/stand/pitclamp-handle.step
79.3 x 19.3 x 16.0 mm
