researchanddesire/OSSM/hardware/cad/stand/pcb-mount-lid.step

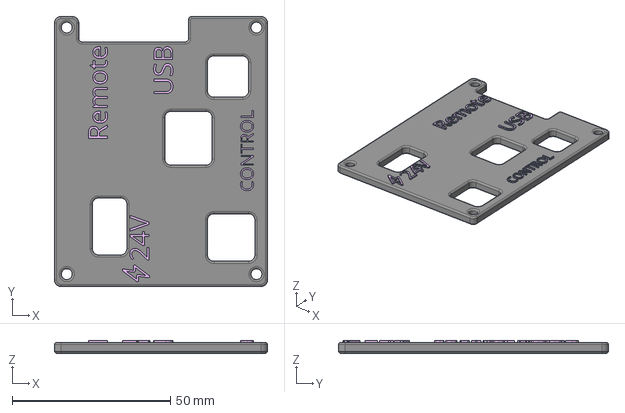
[picture p22: CAD file, 2026-10-08]
hardware/cad/stand/pcb-mount-lid.step
67.4 x 85.4 x 4.00 mm
