researchanddesire/OSSM/hardware/cad/stand/end-cap.step

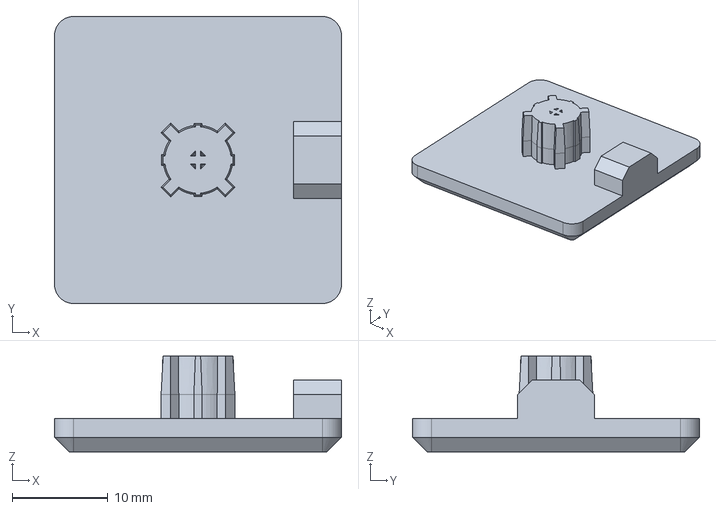
[picture p23: CAD file, 2026-10-08]
hardware/cad/stand/end-cap.step
30.0 x 30.0 x 10.00 mm
