researchanddesire/OSSM/hardware/cad/stand/57aim-ring-v1.1.step

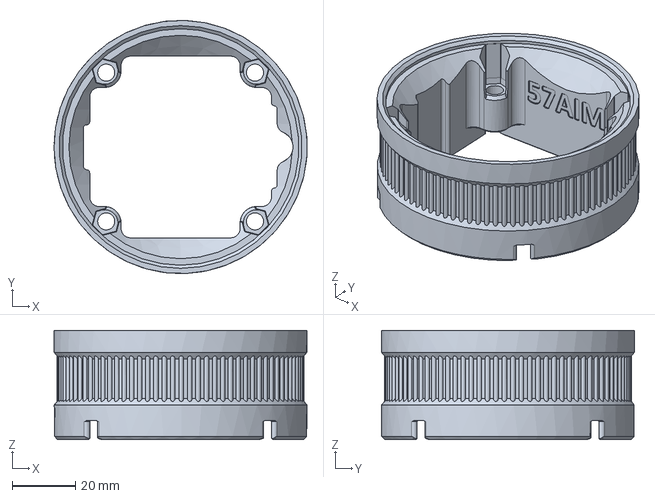
[picture p24: CAD file, 2026-10-08]
hardware/cad/stand/57aim-ring-v1.1.step
79.9 x 80.0 x 34.6 mm
