researchanddesire/OSSM/hardware/cad/stand/pitclamp-dogbone-hex.step

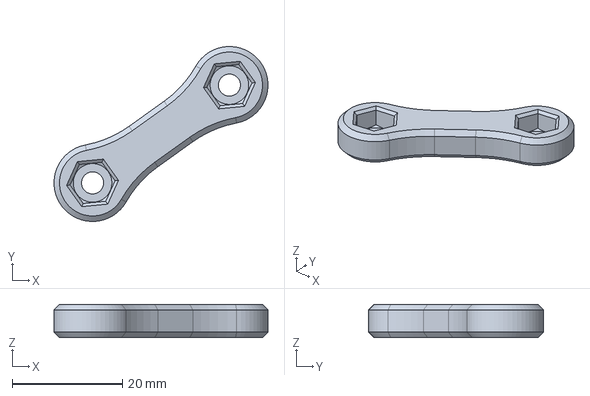
[picture p25: CAD file, 2026-10-08]
hardware/cad/stand/pitclamp-dogbone-hex.step
38.8 x 31.7 x 6.00 mm
