researchanddesire/OSSM/hardware/cad/stand/pitclamp-upper-v1.1.step

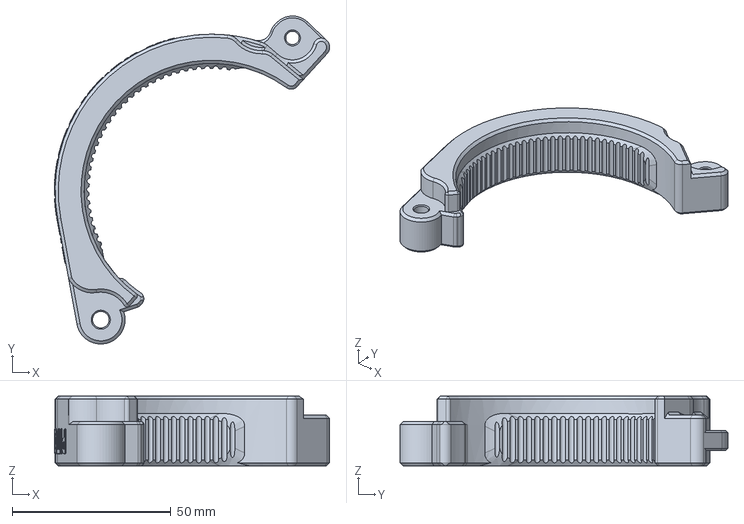
[picture p26: CAD file, 2026-10-08]
hardware/cad/stand/pitclamp-upper-v1.1.step
86.7 x 103.3 x 22.0 mm
