researchanddesire/OSSM/(list of files, cad)

Other CAD files:
hardware/cad/stand/pivot-plate-1.step
hardware/cad/stand/pitclamp-dogbone-round.step
hardware/cad/actuator/24mm-jam-nut.step
