researchanddesire/OSSM/assembly-docs/build-guides.mdx

---
title: Build Guides
description: Step-by-step PDF build guides for the OSSM stand, actuator, wiring and wired remote, and a guide to mounting a toy.
---

Build an OSSM in this order: the stand, the actuator, the wiring, then the wired
remote. Each guide starts where the one before it ends. The toy mounting guide
then shows how to mount a toy on the finished OSSM.

## Current guides

<div className="not-prose my-6" style={{ display: "grid", gridTemplateColumns: "repeat(auto-fill, minmax(min(100%, 10rem), 1fr))", gap: "1rem" }}>

<Photo caption={<a href="https://github.com/researchanddesire/OSSM/blob/main/hardware/build-guides/stand-1.0.pdf" style={{ textDecoration: "underline", textUnderlineOffset: "3px" }}>Stand 1.0</a>}>

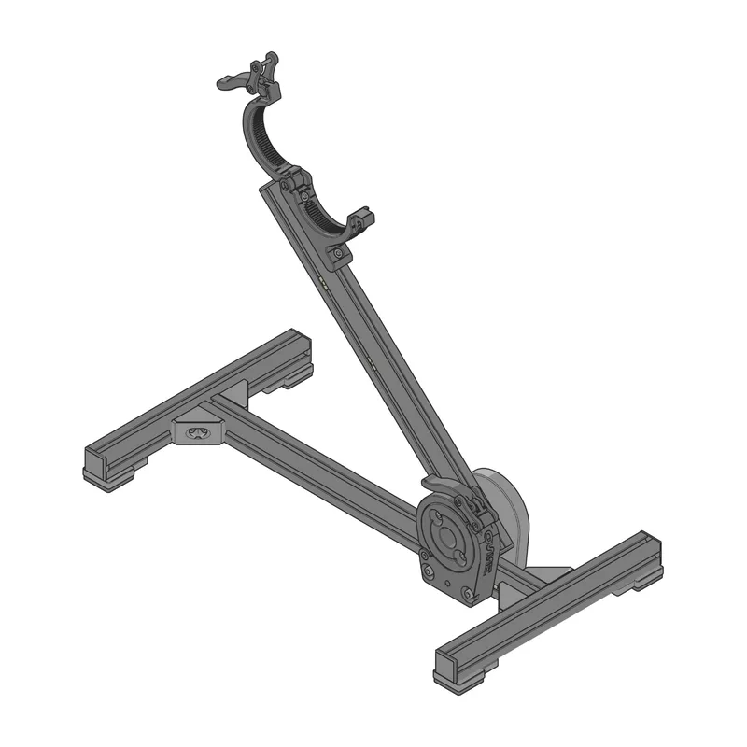
[picture p27: assembly-docs/assets/build-guides/stand-1.0.webp]
The finished PitClamp stand


</Photo>

<Photo caption={<a href="https://github.com/researchanddesire/OSSM/blob/main/hardware/build-guides/actuator-1.1.pdf" style={{ textDecoration: "underline", textUnderlineOffset: "3px" }}>Actuator 1.1</a>}>

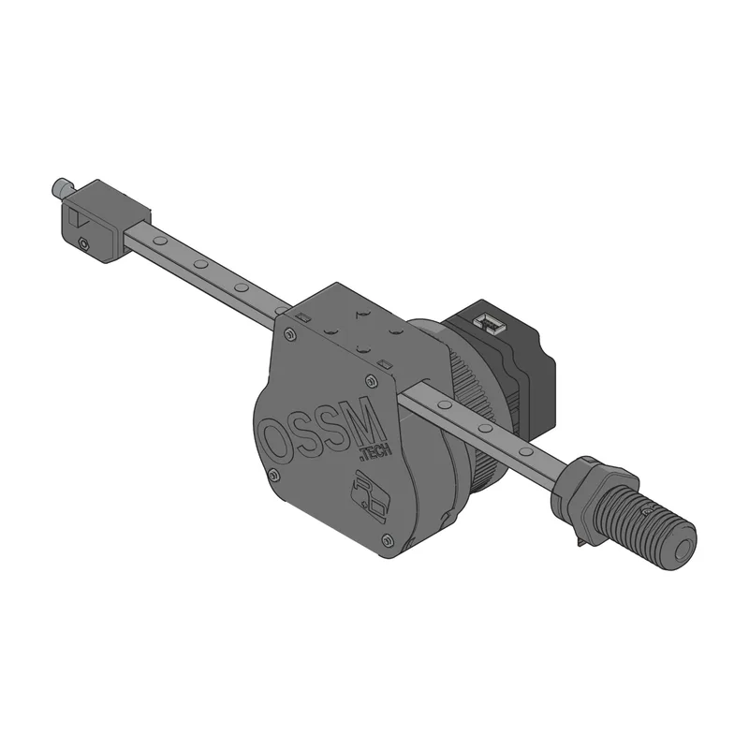
[picture p28: assembly-docs/assets/build-guides/actuator-1.1.webp]
The finished actuator


</Photo>

<Photo caption={<a href="https://github.com/researchanddesire/OSSM/blob/main/hardware/build-guides/wiring-1.0.pdf" style={{ textDecoration: "underline", textUnderlineOffset: "3px" }}>Wiring 1.0</a>}>

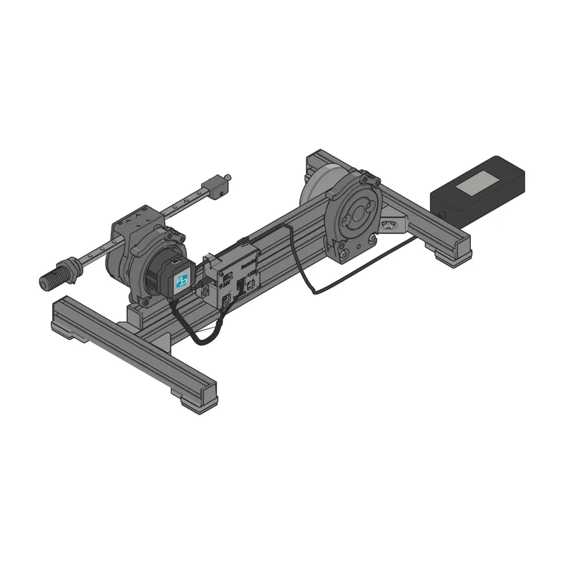
[picture p29: assembly-docs/assets/build-guides/wiring-1.0.webp]
The wired OSSM on its stand, with the power supply


</Photo>

<Photo caption={<a href="https://github.com/researchanddesire/OSSM/blob/main/hardware/build-guides/remote-1.0.pdf" style={{ textDecoration: "underline", textUnderlineOffset: "3px" }}>Wired Remote 1.0</a>}>

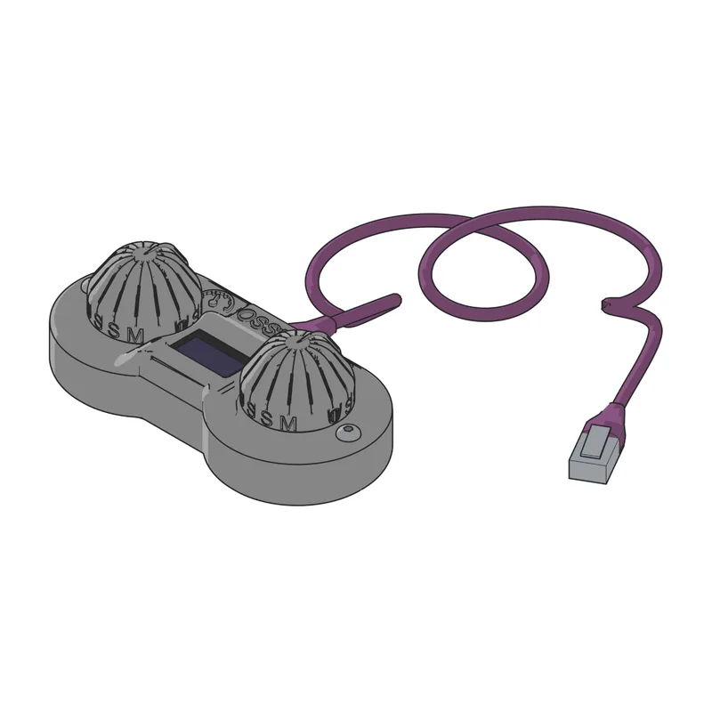
[picture p30: assembly-docs/assets/build-guides/remote-1.0.webp]
The finished wired remote with its cable


</Photo>

<Photo caption={<a href="https://github.com/researchanddesire/OSSM/blob/main/hardware/build-guides/toy-mounting-1.0.pdf" style={{ textDecoration: "underline", textUnderlineOffset: "3px" }}>Toy Mounting 1.0</a>}>

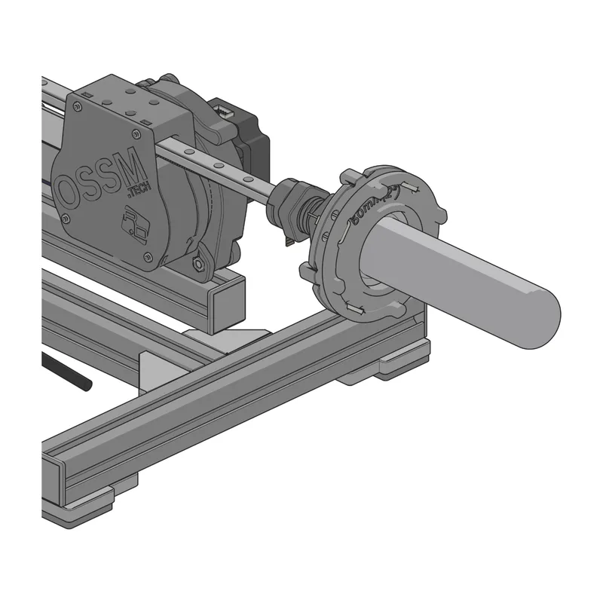
[picture p31: assembly-docs/assets/build-guides/toy-mounting-1.0.webp]
A toy mounted on the end effector with the flange plates


</Photo>

</div>

| Guide | Edition | Covers | PDF |
| --- | --- | --- | --- |
| Stand Build Guide | 1.0 | The PitClamp stand: the 3030 extrusion frame, a pivot plate and PitClamp on the body, and the PitClamp Mini V1.1 on the arm. | [View](https://github.com/researchanddesire/OSSM/blob/main/hardware/build-guides/stand-1.0.pdf) · [Download](https://github.com/researchanddesire/OSSM/raw/main/hardware/build-guides/stand-1.0.pdf) |
| Actuator Build Guide | 1.1 | The servo in its motor ring, the MGN12H rail, the GT2 belt with its tensioner, and the 24 mm Clamping Thread end effector with its belt clamp ring and lock nut. The same actuator fits every stand. | [View](https://github.com/researchanddesire/OSSM/blob/main/hardware/build-guides/actuator-1.1.pdf) · [Download](https://github.com/researchanddesire/OSSM/raw/main/hardware/build-guides/actuator-1.1.pdf) |
| Wiring Guide | 1.0 | The V2.3 board in its PCB box on the arm, the motor harness from the servo to the board, and the 24 V power supply. | [View](https://github.com/researchanddesire/OSSM/blob/main/hardware/build-guides/wiring-1.0.pdf) · [Download](https://github.com/researchanddesire/OSSM/raw/main/hardware/build-guides/wiring-1.0.pdf) |
| Wired Remote Guide | 1.0 | The Remote V2 board in its printed body and cover, two knobs, and the purple CAT6 cable into the OSSM's REMOTE port. | [View](https://github.com/researchanddesire/OSSM/blob/main/hardware/build-guides/remote-1.0.pdf) · [Download](https://github.com/researchanddesire/OSSM/raw/main/hardware/build-guides/remote-1.0.pdf) |
| Toy Mounting Guide | 1.0 | Two ways to mount a toy on the 24 mm threaded end effector, each locked by a lock nut: the flange base and flange ring tied through their holes, or the Vac-U-Lock adapter, and how to check the toy is held. | [View](https://github.com/researchanddesire/OSSM/blob/main/hardware/build-guides/toy-mounting-1.0.pdf) · [Download](https://github.com/researchanddesire/OSSM/raw/main/hardware/build-guides/toy-mounting-1.0.pdf) |

The wiring and wired remote guides show the PitClamp stand.

## Earlier hardware

Use these guides for an OSSM built with the earlier parts.

<div className="not-prose my-6" style={{ display: "grid", gridTemplateColumns: "repeat(auto-fill, minmax(min(100%, 10rem), 1fr))", gap: "1rem" }}>

<Photo caption={<a href="https://github.com/researchanddesire/OSSM/blob/main/hardware/build-guides/actuator-1.0.pdf" style={{ textDecoration: "underline", textUnderlineOffset: "3px" }}>Actuator 1.0</a>}>

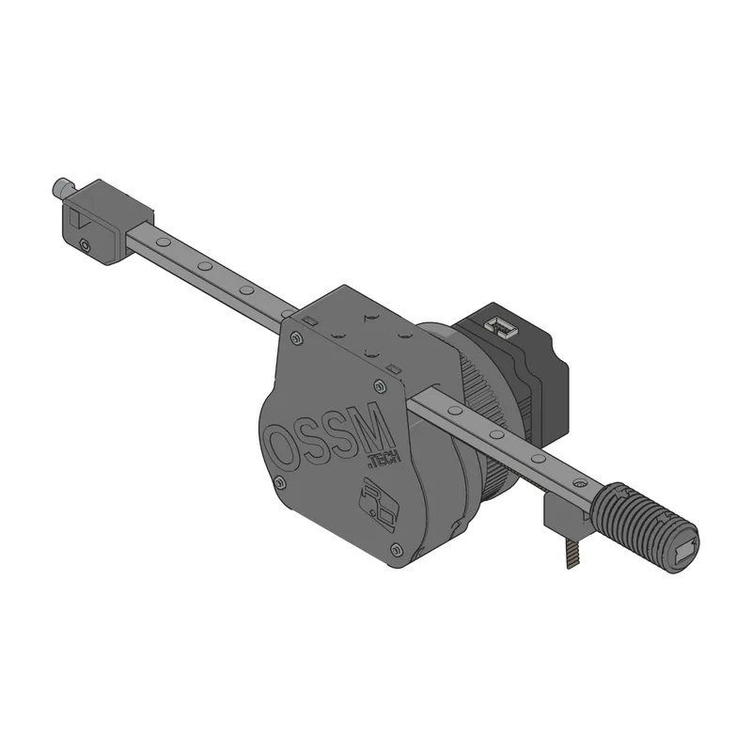
[picture p32: assembly-docs/assets/build-guides/actuator-1.0.webp]
The finished actuator with the earlier end effector


</Photo>

<Photo caption={<a href="https://github.com/researchanddesire/OSSM/blob/main/hardware/build-guides/stand-0.1.pdf" style={{ textDecoration: "underline", textUnderlineOffset: "3px" }}>Stand 0.1</a>}>

The finished pivot-plate stand

</Photo>

<Photo caption={<a href="https://github.com/researchanddesire/OSSM/blob/main/hardware/build-guides/stand-0.0.pdf" style={{ textDecoration: "underline", textUnderlineOffset: "3px" }}>Stand 0.0</a>}>

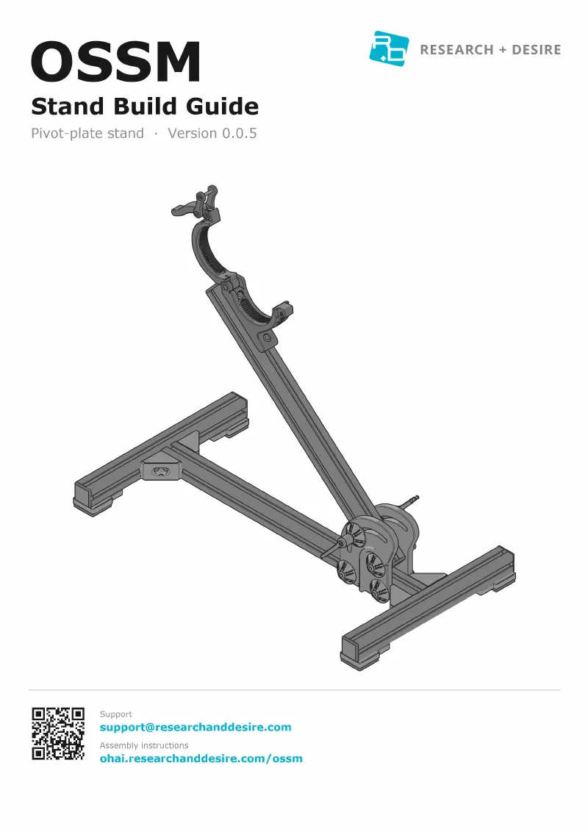
[picture p33: assembly-docs/assets/build-guides/stand-0.0.webp]
The finished pivot-plate stand with the earlier PitClamp Mini


</Photo>

</div>

| Guide | Edition | Covers | PDF |
| --- | --- | --- | --- |
| Actuator Build Guide | 1.0 | The same actuator with the earlier end effector: the 24 mm thread and a separate belt clamp. | [View](https://github.com/researchanddesire/OSSM/blob/main/hardware/build-guides/actuator-1.0.pdf) · [Download](https://github.com/researchanddesire/OSSM/raw/main/hardware/build-guides/actuator-1.0.pdf) |
| Stand Build Guide | 0.1 | The pivot-plate stand: two printed pivot plates with adjustable M6 handles, and the PitClamp Mini V1.1 on the arm. | [View](https://github.com/researchanddesire/OSSM/blob/main/hardware/build-guides/stand-0.1.pdf) · [Download](https://github.com/researchanddesire/OSSM/raw/main/hardware/build-guides/stand-0.1.pdf) |
| Stand Build Guide | 0.0 | The pivot-plate stand with the earlier PitClamp Mini kit, whose handle sits on a separate M4×12 pin. | [View](https://github.com/researchanddesire/OSSM/blob/main/hardware/build-guides/stand-0.0.pdf) · [Download](https://github.com/researchanddesire/OSSM/raw/main/hardware/build-guides/stand-0.0.pdf) |

## Editions

Each guide's cover shows its full version number, such as 1.0.14 for Stand
1.0. The first number is the hardware version, the second counts compatible
part changes, and the third counts documentation corrections. A file always
holds the latest corrections for its edition.

The parts for these builds are in the [bill of materials](/ossm/bom), and the
motor harness has its own [wiring diagram](/ossm/cable-harnesses). The PDFs
are kept in the
[OSSM repository](https://github.com/researchanddesire/OSSM/tree/main/hardware/build-guides).
For help, email [support@researchanddesire.com](mailto:support@researchanddesire.com).
