researchanddesire/OSSM/assembly-docs/cable-harnesses.mdx

---
title: Cable Harnesses
---

## Motor Control Harness

[View wiring diagram](https://github.com/researchanddesire/OSSM/tree/main/hardware/cables#readme) · [WireViz YAML](https://github.com/researchanddesire/OSSM/blob/main/hardware/cables/OSSM-Motor-Control-Harness.yml) · [Cable BOM](https://github.com/researchanddesire/OSSM/blob/main/hardware/cables/OSSM-Motor-Control-Harness.bom.tsv) · [Download PDF](https://github.com/researchanddesire/OSSM/actions/workflows/render-cables.yml)
