researchanddesire/OSSM/assembly-docs/assembly-guide.md

# Assembly Guide

The OSSM assembly guide is awaiting migration from the current operational
hardware sources.

## Migration Checklist

- Confirm the release CAD exports in [`hardware/cad/`](../hardware/cad/).
- Confirm PCB source migration status in [`hardware/pcb/`](../hardware/pcb/).
- Confirm Wireviz harness output from [`hardware/cables/`](../hardware/cables/).
- Populate [`hardware/bom.csv`](../hardware/bom.csv) with product-level line items.
- Replace this checklist with the ordered build sequence and assembly photos.

Do not invent assembly steps before the release source package is complete.
