researchanddesire/OSSM/assembly-docs/index.md

# OSSM Assembly Docs

OSSM assembly documentation is being migrated into this repository from the
current operational hardware sources. This package publishes the assembly-docs
surface for Ohai while the complete build sequence and release assets are
filled in.

## Source Map

| Area | Source |
| --- | --- |
| Product-level BOM | [`hardware/bom.csv`](../hardware/bom.csv) |
| CAD release exports | [`hardware/cad/`](../hardware/cad/) |
| PCB source notes | [`hardware/pcb/`](../hardware/pcb/) |
| Cable harness sources | [`hardware/cables/`](../hardware/cables/) |
| Current upstream hardware reference | [KinkyMakers/OSSM-hardware](https://github.com/KinkyMakers/OSSM-hardware) |

## Assembly Package

- [PCB Overview](pcb-overview.md)
- [Cable Harnesses](cable-harnesses.md)
- [Bill of Materials](bom.md)
- [Assembly Guide](assembly-guide.md)
