researchanddesire/OSSM/hardware/cables/images/OSSM_Harness_Installed.png

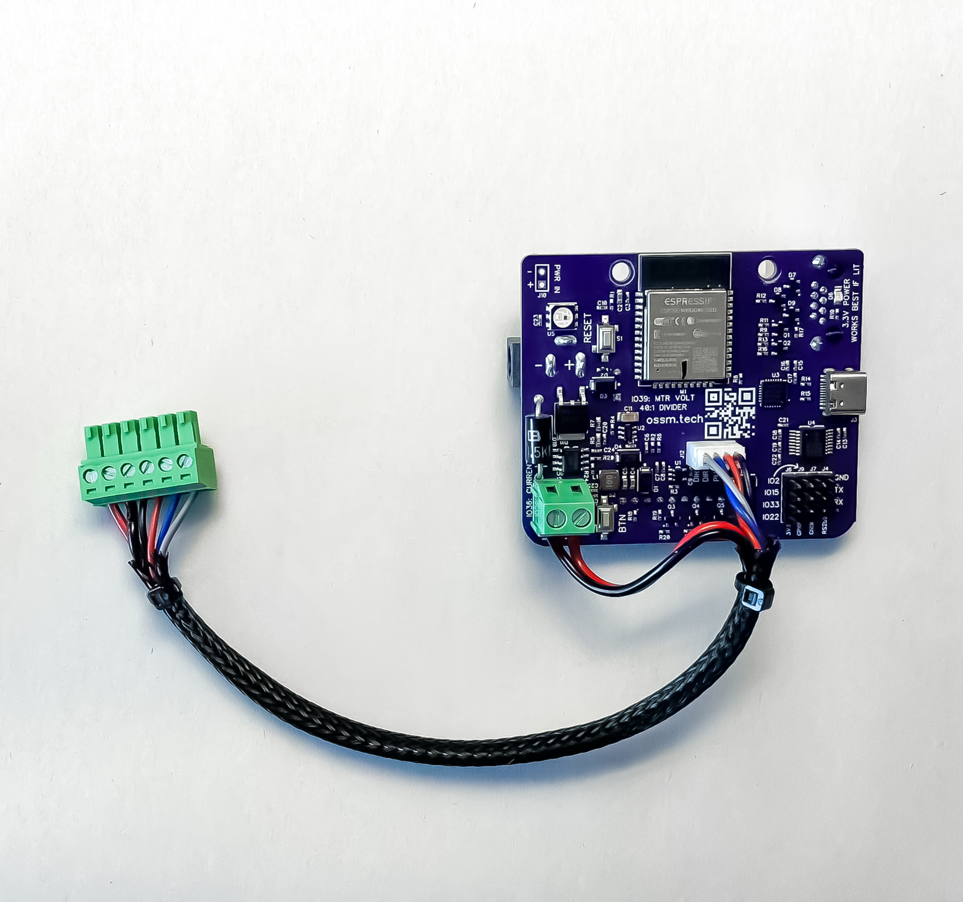
hardware/cables/images/OSSM_Harness_Installed.png
