researchanddesire/OSSM/Software/src/main.cpp

#include "Arduino.h"
#include "OneButton.h"
#include "components/HeaderBar.h"
#include "esp_log.h"
#include "ossm/Events.h"
#include "ossm/OSSM.h"
#include "ossm/pages/pairing.h"
#include "ossm/state/state.h"
#include "services/board.h"
#include "services/radHil.h"
#include "services/communication/mqtt.h"
#include "services/communication/nimble.h"
#include "services/display.h"
#include "services/encoder.h"
#include "services/led.h"
#include "services/stepper.h"
#include "services/wm.h"
#include "utils/firmware_md5.h"
#include "utils/update.h"

namespace sml = boost::sml;
using namespace sml;

/*
 *  ██████╗ ███████╗███████╗███╗   ███╗
 * ██╔═══██╗██╔════╝██╔════╝████╗ ████║
 * ██║   ██║███████╗███████╗██╔████╔██║
 * ██║   ██║╚════██║╚════██║██║╚██╔╝██║
 * ╚██████╔╝███████║███████║██║ ╚═╝ ██║
 *  ╚═════╝ ╚══════╝╚══════╝╚═╝     ╚═╝
 *
 * Welcome to the open source sex machine!
 * This is a product of Kinky Makers and is licensed under the MIT license.
 *
 * Research and Desire is a financial sponsor of this project.
 *
 * But our biggest sponsor is you! If you want to support this project, please
 * contribute, fork, branch and share!
 */

OneButton button(Pins::Remote::encoderSwitch, false);

#ifdef CONFIG_APP_ROLLBACK_ENABLE
// Keep Arduino core startup from accepting a pending image before OSSM has
// initialized enough of the application to confirm it explicitly.
extern "C" bool verifyRollbackLater() { return true; }
#endif

void __attribute__((weak)) setup() {
    // Suppress verbose GPIO configuration logs
    esp_log_level_set("gpio", ESP_LOG_WARN);

    /** Board setup */
    initBoard();
    radHilStart();

    ESP_LOGD("MAIN", "Starting OSSM");

    // Display
    initDisplay();

    // Initialize header bar task
    initHeaderBar();

    // Create OSSM instance for backward compatibility (BLE command handling)
    ossm = new OSSM();

    // Initialize state machine after global state is set up
    initStateMachine();

    // The board, display, and state machine initialized successfully. Confirm
    // the running image if a rollback-capable bootloader marked it pending.
    ossmConfirmRunningImage();
    cacheSketchMd5();  // before BLE/Wi-Fi/MQTT: getSketchMD5 needs a big buffer

    // ialize LED for BLE and machine status indication
    ESP_LOGI("MAIN", "LED initialized for BLE and machine status indication");
    updateLEDForMachineStatus();  // Set initial LED state

    // // link functions to be called on events.
    button.attachClick([]() { stateMachine->process_event(ButtonPress{}); });
    button.attachDoubleClick(
        []() { stateMachine->process_event(DoublePress{}); });
    button.attachLongPressStart(
        []() { stateMachine->process_event(LongPress{}); });

    xTaskCreatePinnedToCore(
        [](void *pvParameters) {
            while (true) {
                button.tick();
                vTaskDelay(25 / portTICK_PERIOD_MS);
            }
        },
        "buttonTask", 4 * configMINIMAL_STACK_SIZE, nullptr,
        configMAX_PRIORITIES - 1, nullptr, 0);

    // Communication must remain available while homing and in motor-power
    // error states. This also makes diagnostics and recovery possible when the
    // drive supply is intentionally disconnected.
    xTaskCreatePinnedToCore(
        [](void *pvParameters) {
            ESP_LOGD("MAIN", "Initializing communication services");
            initNimble();
            initWM();
            // The MQTT TLS session competes with homing for internal RAM and
            // can leave the backward homing pass unable to start. Bring MQTT
            // and the pairing check up once the boot homing run is over
            // (capped so comms still come up if something else stalls).
            // Later re-homes pause and resume MQTT themselves.
            for (int waited = 0; waited < 1200; waited++) {
                const bool bootHomingPending =
                    stateMachine->is("idle"_s) ||
                    stateMachine->is("homing"_s) ||
                    stateMachine->is("homing.forward"_s) ||
                    stateMachine->is("homing.backward"_s);
                if (!bootHomingPending) break;
                vTaskDelay(pdMS_TO_TICKS(100));
            }
            initMQTT();
            pages::startPairingStatusCheck();
            vTaskDelete(nullptr);
        },
        "initNimbleTask", 32 * configMINIMAL_STACK_SIZE, nullptr,
        configMAX_PRIORITIES - 1, nullptr, 0);
};

void __attribute__((weak)) loop() { vTaskDelete(nullptr); };
