researchanddesire/OSSM/Software/src/services/board.cpp

#include "services/serialIdentity.h"
#include "board.h"

bool USE_LATENCY_COMPENSATION = false;
bool USE_SPEED_KNOB_AS_LIMIT = true;

void initBoard() {
    configureSerialIdentityUsb();
    Serial.begin(115200);
    startSerialIdentity();

    pinMode(Pins::Remote::encoderSwitch,
            INPUT_PULLDOWN);  // Rotary Encoder Pushbutton

    pinMode(Pins::GPIO::pin1, OUTPUT);
    pinMode(Pins::GPIO::pin2, OUTPUT);
    pinMode(Pins::GPIO::pin3, OUTPUT);
    pinMode(Pins::GPIO::pin4, OUTPUT);

    pinMode(Pins::Driver::motorEnablePin, OUTPUT);
    pinMode(Pins::Wifi::resetPin, INPUT_PULLDOWN);
    pinMode(Pins::Remote::speedPotPin, INPUT);
    adcAttachPin(Pins::Remote::speedPotPin);

    analogReadResolution(12);
    analogSetAttenuation(ADC_11db);  // allows us to read almost full 3.3V range
    initStepper();
    initEncoder();
    initLED();
}
