researchanddesire/OSSM/software/firmware/src/ossm/pattern_controls/pattern_controls.cpp

#include "pattern_controls.h"

#include "Strings.h"
#include "constants/Pins.h"
#include "services/board.h"
#include "ossm/state/settings.h"
#include "ossm/state/state.h"
#include "services/display.h"
#include "services/encoder.h"
#include "services/tasks.h"
#include "structs/SettingPercents.h"
#include "ui.h"
#include "utils/analog.h"
#include "utils/format.h"
#include "components/HeaderBar.h"

namespace sml = boost::sml;
using namespace sml;

namespace pattern_controls {

static size_t numberOfDescriptions =
    sizeof(ui::strings::strokeEngineDescriptions) /
    sizeof(ui::strings::strokeEngineDescriptions[0]);
static size_t numberOfPatterns = 7;

static void drawPatternControlsTask(void *pvParameters) {
    SettingPercents savedSettings = settings;

    auto isInCorrectState = []() {
        return stateMachine->is("strokeEngine.pattern"_s);
    };

    int nextPattern = (int)settings.pattern;
    bool shouldUpdateDisplay = true;
    const char *patternName = "nextPattern";
    const char *patternDescription =
        ui::strings::strokeEngineDescriptions[nextPattern];

    encoder.setAcceleration(10);
    encoder.setBoundaries(0, numberOfPatterns * 3 - 1, true);
    encoder.setEncoderValue(nextPattern * 3);

    showHeaderIcons = true;

    while (isInCorrectState()) {
        nextPattern = encoder.readEncoder() / 3;
        float speed;
        float speedKnob = readSpeedKnobPercent();
        settings.speedKnob = speedKnob;
        if (USE_SPEED_KNOB_AS_LIMIT || !settings.speedBLE.has_value()) {
            speed = speedKnob * (settings.speedBLE.value_or(100)) / 100;
        } else {
            speedKnob = settings.speedBLE.value_or(100);
            speed = settings.speedBLE.value_or(100);
        }

        if (speed != settings.speed) {
            shouldUpdateDisplay = true;
            settings.speed = speed;
        }

        shouldUpdateDisplay =
            shouldUpdateDisplay || (int)settings.pattern != nextPattern;
        if (!shouldUpdateDisplay) {
            vTaskDelay(100);
            continue;
        }

        patternName = ui::strings::strokeEngineNames[nextPattern];

        if (nextPattern < (int)numberOfDescriptions) {
            patternDescription =
                ui::strings::strokeEngineDescriptions[nextPattern];
        } else {
            patternDescription = ui::strings::noDescription;
        }

        settings.pattern = (StrokePatterns)nextPattern;

        if (xSemaphoreTake(displayMutex, 100) == pdTRUE) {
            ui::TextPage page;
            page.title = patternName;
            page.body = patternDescription;
            page.scrollPercent =
                ui::scrollPercent(nextPattern, numberOfPatterns);
            ui::drawTextPage(display.getU8g2(), page);
            refreshPage(true, true);
            xSemaphoreGive(displayMutex);
        }

        vTaskDelay(200);
    }

    vTaskDelete(nullptr);
};

void drawPatternControls() {
    int stackSize = 3 * configMINIMAL_STACK_SIZE;
    xTaskCreate(drawPatternControlsTask, "drawPatternControlsTask", stackSize,
                nullptr, 1, &Tasks::drawPatternControlsTaskH);
}

}  // namespace pattern_controls
