researchanddesire/OSSM/software/firmware/src/ossm/state/guards.cpp

#include "guards.h"

#include "guard_logic.h"
#include "constants/Config.h"
#include "constants/Pins.h"
#include "ossm/homing/homing.h"
#include "ossm/state/calibration.h"
#include "ossm/state/menu.h"
#include "services/board.h"
#include "utils/analog.h"
#include "ossm/Events.h"
#include "services/motorSafety.h"

bool ossmMotorSafetyEventCurrent(const MotorSafetyFault &event) {
    return motorSafetyEventCurrent(event.revision);
}

bool ossmIsStrokeTooShort() {
    return homing::isStrokeTooShort();
}

bool ossmIsNotHomed() {
    return calibration.isHomed == false;
}

bool ossmIsPreflightSafe() {
    float potReading = readSpeedKnobPercent();
    return guard_logic::isPreflightSafeLogic(
        potReading, Config::Advanced::commandDeadZonePercentage);
}

Menu ossmGetMenuOption() {
    return menuState.currentOption;
}
