researchanddesire/OSSM/software/firmware/test/test_ossm_hat/main.cpp

#include <unity.h>

#include <array>
#include <vector>

#include "../../src/services/ossmHatProtocol.hpp"

void setUp() {}
void tearDown() {}

using ossm_hat::Decoder;

namespace {

void appendCrc(std::vector<uint8_t> &frame) {
    const uint16_t crc = AimFrame::crc16(frame.data(), frame.size());
    frame.push_back(crc & 0xFF);
    frame.push_back(crc >> 8);
}

std::vector<uint8_t> request(uint16_t start = 0x0E, uint16_t count = 12,
                             uint8_t id = 1) {
    std::vector<uint8_t> result(8);
    AimFrame::buildRead(result.data(), id, start, count);
    return result;
}

std::vector<uint8_t> reply(uint16_t start = 0x0E, uint16_t count = 12,
                          int32_t position = -87259, uint8_t id = 1) {
    std::array<uint16_t, 26> words{};
    words[0] = 0;  // STEP/DIR control
    words[1] = 7;  // shipped motor output-enable value
    words[0x0E] = 0x10;
    words[0x0F] = 3500;  // 1.75 A
    words[0x10] = static_cast<uint16_t>(-123);  // -12.3 RPM
    words[0x11] = 7848;  // 24 V
    words[0x12] = 42;  // degrees C
    words[0x13] = static_cast<uint16_t>(-16384);  // -50% output
    words[0x16] = static_cast<uint32_t>(position) & 0xFFFF;
    words[0x17] = static_cast<uint32_t>(position) >> 16;
    std::vector<uint8_t> result{id, 3, static_cast<uint8_t>(2 * count)};
    for (size_t i = start; i < start + count; ++i) {
        result.push_back(words[i] >> 8);
        result.push_back(words[i] & 0xFF);
    }
    appendCrc(result);
    return result;
}

uint8_t feed(Decoder &decoder, const std::vector<uint8_t> &bytes,
             uint32_t time = 100) {
    uint8_t events = 0;
    for (auto byte : bytes) events |= decoder.push(byte, time);
    return events;
}

}  // namespace

void test_passive_guard_block_decodes_all_fields() {
    Decoder decoder;
    TEST_ASSERT_EQUAL(Decoder::ExternalRequest, feed(decoder, request()));
    decoder.push(0, 101);  // known HAT turnaround glitch
    TEST_ASSERT_EQUAL(Decoder::Telemetry, feed(decoder, reply(), 102));
    const auto sample = decoder.sample();
    TEST_ASSERT_EQUAL_INT32(-87259, sample.positionCounts);
    TEST_ASSERT_FLOAT_WITHIN(0.0001f, 1.75f, sample.currentAmps);
    TEST_ASSERT_FLOAT_WITHIN(0.0001f, 24.0f, sample.voltageVolts);
    TEST_ASSERT_FLOAT_WITHIN(0.0001f, -12.3f, sample.speedRpm);
    TEST_ASSERT_FLOAT_WITHIN(0.0001f, 42.0f, sample.temperatureC);
    TEST_ASSERT_FLOAT_WITHIN(0.0001f, -50.0f, sample.outputPercent);
    TEST_ASSERT_EQUAL_HEX16(0x10, sample.alarm);
    TEST_ASSERT_EQUAL_UINT32(102, sample.updatedAtMs);
    TEST_ASSERT_TRUE(ossm_hat::fresh(sample, 200));
    TEST_ASSERT_FALSE(ossm_hat::fresh(sample, 353));
}

void test_manual_read_vector_and_captured_glitch_reply() {
    // YZ-AIM manual read-position vector and Alex's V2.3 bench capture.
    // These fixed bytes verify CRC independently of this test's builders.
    const uint8_t expected[]{1, 3, 0, 0x16, 0, 2, 0x25, 0xCF};
    uint8_t actual[8];
    AimFrame::buildRead(actual, 1, 0x16, 2);
    TEST_ASSERT_EQUAL_HEX8_ARRAY(expected, actual, sizeof(expected));
    const uint8_t captured[]{0, 1, 3, 2, 3, 0x20, 0xB9, 0x6C};
    const auto parsed = AimFrame::parseReply(captured, sizeof(captured), 1, 3, 7);
    TEST_ASSERT_EQUAL(static_cast<int>(AimFrame::Status::Ok),
                      static_cast<int>(parsed.status));
    TEST_ASSERT_EQUAL_UINT32(1, parsed.skipped);
    TEST_ASSERT_EQUAL_UINT16(800, AimFrame::be16(captured + parsed.offset + 3));
}

void test_active_read_does_not_report_external_master() {
    Decoder decoder;
    decoder.expectRead(1, 0x0E, 10, 10);
    TEST_ASSERT_EQUAL(Decoder::Telemetry, feed(decoder, reply(0x0E, 10, 65537), 11));
    TEST_ASSERT_EQUAL_INT32(65537, decoder.sample().positionCounts);
}

void test_encoder_high_and_low_words_include_signed_position() {
    for (int32_t position : {INT32_MIN, INT32_MAX, -1, 0, 32768}) {
        Decoder decoder;
        feed(decoder, request());
        feed(decoder, reply(0x0E, 12, position), 101);
        TEST_ASSERT_EQUAL_INT32(position, decoder.sample().positionCounts);
    }
}

void test_whole_register_snapshot_uses_requested_offset() {
    Decoder decoder;
    feed(decoder, request(0, 26));
    TEST_ASSERT_EQUAL(Decoder::Telemetry | Decoder::Controls,
                      feed(decoder, reply(0, 26), 101));
    TEST_ASSERT_EQUAL_INT32(-87259, decoder.sample().positionCounts);
    TEST_ASSERT_FLOAT_WITHIN(0.0001f, 1.75f, decoder.sample().currentAmps);
}

void test_unsolicited_response_cannot_detect_hat() {
    Decoder decoder;
    TEST_ASSERT_EQUAL(Decoder::None, feed(decoder, reply()));
    TEST_ASSERT_EQUAL_UINT32(0, decoder.sample().sequence);
}

void test_partial_read_never_makes_current_voltage_fresh() {
    Decoder decoder;
    feed(decoder, request(0x16, 2));
    TEST_ASSERT_EQUAL(Decoder::None, feed(decoder, reply(0x16, 2), 101));
    TEST_ASSERT_EQUAL_UINT32(0, decoder.sample().sequence);
}

void test_bad_crc_does_not_refresh_a_sample() {
    Decoder decoder;
    feed(decoder, request());
    feed(decoder, reply(), 101);
    decoder.reset();
    feed(decoder, request(), 400);
    auto damaged = reply();
    damaged[6] ^= 1;
    feed(decoder, damaged, 401);
    TEST_ASSERT_EQUAL_UINT32(1, decoder.sample().sequence);
    TEST_ASSERT_EQUAL_UINT32(101, decoder.sample().updatedAtMs);
    TEST_ASSERT_FALSE(ossm_hat::fresh(decoder.sample(), 401));
    TEST_ASSERT_GREATER_THAN_UINT32(0, decoder.crcErrors());
}

void test_wrong_server_and_byte_count_rejected() {
    Decoder decoder;
    feed(decoder, request());
    TEST_ASSERT_EQUAL(Decoder::None, feed(decoder, reply(0x0E, 12, 0, 2), 101));
    TEST_ASSERT_EQUAL_UINT32(0, decoder.sample().sequence);
    TEST_ASSERT_EQUAL(Decoder::None, feed(decoder, reply(0x0E, 10), 102));
    TEST_ASSERT_EQUAL_UINT32(0, decoder.sample().sequence);
}

void test_timeout_rejects_late_reply() {
    Decoder decoder;
    feed(decoder, request(), 100);
    TEST_ASSERT_EQUAL(Decoder::None, feed(decoder, reply(), 201));
    TEST_ASSERT_EQUAL_UINT32(0, decoder.sample().sequence);
}

void test_fragmented_frame_publishes_only_after_crc() {
    Decoder decoder;
    feed(decoder, request(), 100);
    const auto bytes = reply();
    for (size_t i = 0; i < bytes.size() - 1; ++i) {
        TEST_ASSERT_EQUAL(Decoder::None, decoder.push(bytes[i], 101));
        TEST_ASSERT_EQUAL_UINT32(0, decoder.sample().sequence);
    }
    TEST_ASSERT_EQUAL(Decoder::Telemetry, decoder.push(bytes.back(), 102));
}

void test_exception_invalidates_pending_request() {
    Decoder decoder;
    feed(decoder, request(), 100);
    std::vector<uint8_t> exception{1, 0x83, 2};
    appendCrc(exception);
    feed(decoder, exception, 101);
    TEST_ASSERT_EQUAL(Decoder::None, feed(decoder, reply(), 102));
    TEST_ASSERT_EQUAL_UINT32(0, decoder.sample().sequence);
}

void test_other_master_address_and_stop_write_are_observed() {
    Decoder decoder;
    TEST_ASSERT_EQUAL(Decoder::ExternalRequest, feed(decoder, request(0, 1, 2)));
    std::vector<uint8_t> stop(8);
    AimFrame::buildWriteSingle(stop.data(), 1, 1, 0);
    TEST_ASSERT_EQUAL(Decoder::ExternalRequest, feed(decoder, stop));
}

void test_zero_noise_and_reset_allow_reconnect() {
    Decoder decoder;
    feed(decoder, {0, 0, 255, 255, 0, 0});
    feed(decoder, request());
    TEST_ASSERT_EQUAL(Decoder::Telemetry, feed(decoder, reply(), 101));
    decoder.reset();
    feed(decoder, request(), 500);
    TEST_ASSERT_EQUAL(Decoder::Telemetry, feed(decoder, reply(), 501));
    TEST_ASSERT_EQUAL_UINT32(2, decoder.sample().sequence);
}

void test_freshness_handles_millis_rollover_and_empty_sample() {
    OssmHatTelemetry sample;
    TEST_ASSERT_FALSE(ossm_hat::fresh(sample, 0));
    sample.sequence = 1;
    sample.updatedAtMs = UINT32_MAX - 100;
    TEST_ASSERT_TRUE(ossm_hat::fresh(sample, 20));
    TEST_ASSERT_FALSE(ossm_hat::fresh(sample, 200));
}

void test_noise_header_and_truncated_reply_recover_on_next_transaction() {
    Decoder decoder;
    feed(decoder, {1, 3, 64});  // unsupported unsolicited length must not block
    feed(decoder, request(), 100);
    TEST_ASSERT_EQUAL(Decoder::Telemetry, feed(decoder, reply(), 101));
    feed(decoder, request(), 200);
    feed(decoder, {1, 3, 24, 0}, 201);  // truncated previous reply
    feed(decoder, request(), 210);
    TEST_ASSERT_TRUE(feed(decoder, reply(), 211) & Decoder::Telemetry);
    TEST_ASSERT_EQUAL_UINT32(2, decoder.sample().sequence);
}

void test_fc10_acknowledgement_does_not_block_next_read() {
    Decoder decoder;
    std::vector<uint8_t> acknowledgement{1, 0x10, 0, 0x0C, 0, 2};
    appendCrc(acknowledgement);
    TEST_ASSERT_EQUAL(Decoder::ExternalRequest, feed(decoder, acknowledgement));
    feed(decoder, request());
    TEST_ASSERT_EQUAL(Decoder::Telemetry, feed(decoder, reply(), 101));
}

void test_continuity_changes_after_gap_even_without_consumer_reads() {
    Decoder decoder;
    feed(decoder, request(), 100);
    feed(decoder, reply(), 101);
    TEST_ASSERT_EQUAL_UINT32(1, decoder.sample().continuity);
    decoder.reset();  // ordinary transaction/baud reset preserves continuity
    feed(decoder, request(), 200);
    feed(decoder, reply(), 201);
    TEST_ASSERT_EQUAL_UINT32(1, decoder.sample().continuity);
    // No getter was called while stale: the next fresh response must still
    // invalidate any previous physical home/coordinate anchor.
    decoder.reset();
    feed(decoder, request(), 500);
    feed(decoder, reply(), 501);
    TEST_ASSERT_EQUAL_UINT32(2, decoder.sample().continuity);
    TEST_ASSERT_TRUE(ossm_hat::fresh(decoder.sample(), 501));
    TEST_ASSERT_EQUAL_UINT32(3, decoder.sample().sequence);
}

void test_sample_rate_measures_window_instead_of_configured_poll_rate() {
    ossm_hat::SampleRate rate;
    for (uint32_t time = 0; time <= 1000; time += 20) rate.accepted(time);
    float hz;
    uint32_t window;
    uint16_t count;
    rate.read(1000, hz, window, count);
    TEST_ASSERT_FLOAT_WITHIN(0.01f, 50.0f, hz);
    TEST_ASSERT_EQUAL_UINT32(1000, window);
    TEST_ASSERT_EQUAL_UINT16(51, count);
    rate.read(2001, hz, window, count);
    TEST_ASSERT_EQUAL_FLOAT(0, hz);
    TEST_ASSERT_EQUAL_UINT16(0, count);
}

void test_sample_rate_slow_stream_never_reports_thirty_hz() {
    ossm_hat::SampleRate rate;
    for (uint32_t time = 0; time <= 1000; time += 100) rate.accepted(time);
    float hz;
    uint32_t window;
    uint16_t count;
    rate.read(1000, hz, window, count);
    TEST_ASSERT_FLOAT_WITHIN(0.01f, 10.0f, hz);
    TEST_ASSERT_EQUAL_UINT32(1000, window);
}

void test_sample_rate_requires_new_window_after_stale_gap() {
    ossm_hat::SampleRate rate;
    for (uint32_t time = 0; time <= 1000; time += 20) rate.accepted(time);
    rate.accepted(1300);
    float hz;
    uint32_t window;
    uint16_t count;
    rate.read(1300, hz, window, count);
    TEST_ASSERT_EQUAL_FLOAT(0, hz);
    TEST_ASSERT_EQUAL_UINT32(0, window);
    TEST_ASSERT_EQUAL_UINT16(1, count);
}

void test_sample_rate_handles_ring_and_millis_rollover() {
    ossm_hat::SampleRate rate;
    const uint32_t start = UINT32_MAX - 500;
    for (uint32_t offset = 0; offset <= 2000; offset += 20)
        rate.accepted(start + offset);
    float hz;
    uint32_t window;
    uint16_t count;
    rate.read(start + 2000, hz, window, count);
    TEST_ASSERT_FLOAT_WITHIN(0.01f, 50.0f, hz);
    TEST_ASSERT_EQUAL_UINT32(1000, window);
    TEST_ASSERT_EQUAL_UINT16(51, count);
}

void test_full_block_captures_control_mode_and_output_without_writes() {
    Decoder decoder;
    feed(decoder, request(0, 26), 100);
    feed(decoder, reply(0, 26), 101);
    const auto controls = decoder.controls();
    TEST_ASSERT_TRUE(controls.valid);
    TEST_ASSERT_EQUAL_UINT16(0, controls.modbusEnable);
    TEST_ASSERT_EQUAL_UINT16(7, controls.outputEnable);
    TEST_ASSERT_EQUAL_UINT32(101, controls.updatedAtMs);
    TEST_ASSERT_EQUAL_UINT32(decoder.sample().continuity, controls.continuity);
    TEST_ASSERT_TRUE(ossm_hat::controlsFresh(controls, decoder.sample(), 102));
}

void test_controls_require_fresh_telemetry_and_same_continuity() {
    Decoder decoder;
    feed(decoder, request(0, 26), 100);
    feed(decoder, reply(0, 26), 101);
    const auto controls = decoder.controls();
    TEST_ASSERT_FALSE(ossm_hat::controlsFresh(controls, decoder.sample(), 400));
    decoder.reset();
    feed(decoder, request(), 500);
    feed(decoder, reply(), 501);
    TEST_ASSERT_TRUE(ossm_hat::fresh(decoder.sample(), 501));
    TEST_ASSERT_FALSE(ossm_hat::controlsFresh(controls, decoder.sample(), 501));
}

void test_controls_expire_even_when_regular_telemetry_remains_fresh() {
    Decoder decoder;
    feed(decoder, request(0, 26), 100);
    feed(decoder, reply(0, 26), 101);
    const auto controls = decoder.controls();
    for (uint32_t time = 200; time <= 2200; time += 100) {
        feed(decoder, request(), time);
        feed(decoder, reply(), time + 1);
    }
    TEST_ASSERT_TRUE(ossm_hat::fresh(decoder.sample(), 2201));
    TEST_ASSERT_FALSE(ossm_hat::controlsFresh(controls, decoder.sample(), 2201));
}

void test_partial_or_corrupted_control_response_cannot_refresh_snapshot() {
    Decoder decoder;
    feed(decoder, request(0, 26), 100);
    feed(decoder, reply(0, 26), 101);
    const auto initial = decoder.controls();
    feed(decoder, request(1, 1), 200);
    feed(decoder, reply(1, 1), 201);
    TEST_ASSERT_EQUAL_UINT32(initial.updatedAtMs, decoder.controls().updatedAtMs);
    feed(decoder, request(0, 2), 300);
    auto damaged = reply(0, 2);
    damaged.back() ^= 1;
    feed(decoder, damaged, 301);
    TEST_ASSERT_EQUAL_UINT32(initial.updatedAtMs, decoder.controls().updatedAtMs);
}

void test_priority_readback_replaces_old_mode_snapshot_immediately() {
    Decoder decoder;
    feed(decoder, request(0, 26), 100);
    feed(decoder, reply(0, 26), 101);
    TEST_ASSERT_EQUAL_UINT16(0, decoder.controls().modbusEnable);
    decoder.invalidateControls();
    TEST_ASSERT_FALSE(ossm_hat::controlsFresh(decoder.controls(), decoder.sample(), 102));
    decoder.acceptControlReadback(1, 0, 103);
    TEST_ASSERT_EQUAL_UINT16(1, decoder.controls().modbusEnable);
    TEST_ASSERT_EQUAL_UINT16(0, decoder.controls().outputEnable);
    TEST_ASSERT_EQUAL_UINT32(103, decoder.controls().updatedAtMs);
    TEST_ASSERT_TRUE(ossm_hat::controlsFresh(decoder.controls(), decoder.sample(), 104));
    // Reviewed external control changes only mode; output0 remains valid.
    decoder.acceptControlReadback(0, 0, 105);
    TEST_ASSERT_EQUAL_UINT16(0, decoder.controls().modbusEnable);
    TEST_ASSERT_EQUAL_UINT16(0, decoder.controls().outputEnable);
}

void test_priority_readback_cannot_reuse_a_previous_encoder_epoch() {
    Decoder decoder;
    feed(decoder, request(0, 26), 100);
    feed(decoder, reply(0, 26), 101);
    decoder.acceptControlReadback(0, 0, 102);
    feed(decoder, request(), 500);
    feed(decoder, reply(), 501);
    TEST_ASSERT_FALSE(ossm_hat::controlsFresh(decoder.controls(), decoder.sample(), 501));
    decoder.acceptControlReadback(0, 0, 502);
    TEST_ASSERT_TRUE(ossm_hat::controlsFresh(decoder.controls(), decoder.sample(), 503));
}

int main(int, char **) {
    UNITY_BEGIN();
    RUN_TEST(test_manual_read_vector_and_captured_glitch_reply);
    RUN_TEST(test_passive_guard_block_decodes_all_fields);
    RUN_TEST(test_active_read_does_not_report_external_master);
    RUN_TEST(test_encoder_high_and_low_words_include_signed_position);
    RUN_TEST(test_whole_register_snapshot_uses_requested_offset);
    RUN_TEST(test_unsolicited_response_cannot_detect_hat);
    RUN_TEST(test_partial_read_never_makes_current_voltage_fresh);
    RUN_TEST(test_bad_crc_does_not_refresh_a_sample);
    RUN_TEST(test_wrong_server_and_byte_count_rejected);
    RUN_TEST(test_timeout_rejects_late_reply);
    RUN_TEST(test_fragmented_frame_publishes_only_after_crc);
    RUN_TEST(test_exception_invalidates_pending_request);
    RUN_TEST(test_other_master_address_and_stop_write_are_observed);
    RUN_TEST(test_zero_noise_and_reset_allow_reconnect);
    RUN_TEST(test_freshness_handles_millis_rollover_and_empty_sample);
    RUN_TEST(test_noise_header_and_truncated_reply_recover_on_next_transaction);
    RUN_TEST(test_fc10_acknowledgement_does_not_block_next_read);
    RUN_TEST(test_continuity_changes_after_gap_even_without_consumer_reads);
    RUN_TEST(test_sample_rate_measures_window_instead_of_configured_poll_rate);
    RUN_TEST(test_sample_rate_slow_stream_never_reports_thirty_hz);
    RUN_TEST(test_sample_rate_requires_new_window_after_stale_gap);
    RUN_TEST(test_sample_rate_handles_ring_and_millis_rollover);
    RUN_TEST(test_full_block_captures_control_mode_and_output_without_writes);
    RUN_TEST(test_controls_require_fresh_telemetry_and_same_continuity);
    RUN_TEST(test_controls_expire_even_when_regular_telemetry_remains_fresh);
    RUN_TEST(test_partial_or_corrupted_control_response_cannot_refresh_snapshot);
    RUN_TEST(test_priority_readback_replaces_old_mode_snapshot_immediately);
    RUN_TEST(test_priority_readback_cannot_reuse_a_previous_encoder_epoch);
    return UNITY_END();
}
