researchanddesire/OSSM/(commit log)

2026-06-10 Initial OSSM monorepo skeleton (CERN-OHL-S).
    Opulo-style hardware/ossm layout with bom.csv, cad/cables/pcb placeholders,
    Wireviz export-cables workflow stub, and developer-docs scaffold.
    [bom.csv]
2026-06-10 docs: re-migrate developer docs with improved converter + images + nav
    Re-converts the OSSM Software docs with the upgraded Mintlify migrator:
    proper Steps/admonitions, Tree file-trees as nested lists, Tabs/Frame/
    CodeGroup handling, protected code fences, and normalized cross-links.
    Brings over the co-located doc images and adds .pages nav so the full
    tree shows up in the unified dev-docs site.
2026-06-11 docs(developer-docs): add hardware specs/BOM and license reference
    Add hardware/specs and hardware/bom plus contributing/license migrated
    from the non-technical simple-docs site, with nav wired into mkdocs.yml
    and .pages.
2026-06-12 Add trigger to rebuild unified assembly-docs site on assembly-docs/ changes
2026-06-12 Adds OSSM Motor Control Harness to repo
    [OSSM-Motor-Control-Harness.yml]
2026-06-12 Fix cable harness image resolution in CI
2026-06-12 Use PNG cable harness images and ignore Wireviz output
    [OSSM-Motor-Control-Harness.yml]
2026-06-12 Flatten redundant hardware/ossm into hardware/ (#2)
    The hardware tree had a redundant nested ossm/ folder. Move
    hardware/ossm/* up to hardware/* and update all CI and docs
    references (.gitignore, export-cables.sh, README, CONTRIBUTING).
    [OSSM-Motor-Control-Harness.yml, bom.csv]
2026-06-12 Adopt RAD BOM standard (schema + bom-lint + agent rule) (#3)
    * Adopt RAD BOM standard: schema, agent rule, bom-lint
    Vendor canonical bom.schema.json from dev-docs (read-only), convert
    hardware/bom.csv to the standard header, and add:
    - .cursor/rules/bom.mdc so agents follow the column contract + category codes
    - bom-lint workflow + stdlib validator enforcing header, required fields,
    types, closed category enum, and the en-dash empty-cell rule
    - sync-bom-schema workflow to pull schema updates from dev-docs
    - CONTRIBUTING + PR/issue template links to the BOM standard
    * Move vendored BOM schema next to bom-lint script (CI tooling, not hardwar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
    [bom.csv]
2026-06-12 Add BTY (Battery) part category from BOM standard (#4)
2026-06-12 BOM standard: add FDM category; permissive source rule (#5)
2026-06-16 Add OSSM Ohai assembly docs package
2026-09-04 Route assembly content through rad-app and remove obsolete docs gate
    * Route assembly content synchronization through rad-app
    * Remove obsolete legacy documentation gate
2026-09-04 Synchronize assembly content through rad-app (#2)
    Initialize from researchanddesire/rad-app@1b2e12f7bdef4b8d276ca5f5a015a55d3f347ee2.
    English-only ossm content, shared product assets and BOM snapshots; .en is removed from page/metadata filenames.
2026-09-10 Rebuild OSSM around the preserved motor control harness (#5)
    [(M6 x 15 Cap Head Screw,M6 x 20 Cap Head Screw for 4040 Extrusion).f3d, (M6 x 15 Cap Head Screw,M6 x 20 Cap Head Screw for 4040 Extrusion).stp, 12mmEndPulley.3mf, 12mmEndPulley.stl, 217B_ossm_rev2.dch, 217B_ossm_rev2.dip, 24mm Endcap - Hex Flower.step, 24mm Endcap - Hex Flower.stl]
2026-09-23 Add PR firmware builds and shared hardware validation (#6)
    Add PR firmware builds, enrolled-device validation and development display capture.
    Merged with administrator override at the owner's explicit request. Actions usage and organization runner setup remain outstanding; this merge does not certify successful GitHub hardware validation. Existing release and repository protection settings remain in place.
    [min_spiffs.csv, partitions-4mb.csv]
2026-10-08 Add canonical OSSM hardware BOM
    [bom.csv]
2026-10-08 Publish OSSM BOM assembly page and notify OHAI
    [bom.csv]
2026-10-08 Sort OSSM BOM by category and restore component STEP sources
    [24mm-jam-nut.step, 57aim-ring-v1.1.step, belt-clamp-bottom.step, belt-clamp-top.step, belt-tensioner.step, body-cover.step, body-lower.step, body-middle.step]
2026-10-08 Refresh category-sorted OHAI BOM and repository CAD links
    [bom.csv]
2026-10-08 Consolidate mounting CAD into stand
    [57aim-ring-v1.1.step, bom.csv, pcb-mount-base.step, pcb-mount-lid.step, pitclamp-dogbone-hex.step, pitclamp-dogbone-round.step, pitclamp-handle.step, pitclamp-lower-v1.1.step]
2026-10-08 Refresh OHAI BOM links for consolidated stand CAD
    [bom.csv]
2026-10-08 Render cable harness previews in CI and simplify hardware docs
2026-10-08 Refresh cable harness diagram previews
2026-10-08 Keep WireViz cable BOM alongside harness source
    [OSSM-Motor-Control-Harness.bom.tsv]
2026-10-08 Remove misleading BOM sources for wired remote accessories (#11)
    Set the Remote Ethernet Cable and M4x8mm Buttonhead Screws Source cells to the unspecified marker. Preserve quantities and wired-remote inclusion notes.
    All six firmware builds and Build validation passed. Hardware validation failed with a 16 MB startup deadline timeout; the user explicitly authorized this BOM-only merge despite that failure. No validation workflows or protections are changed.
    [bom.csv]
2026-10-20 Pin FastLED for the legacy 4 MB build
    The legacy 1.0.39 source asks for FastLED ^3.6.0, and October FastLED releases no longer compile against it. Pin 3.10.3, the version the current firmware uses, which builds V1 within its 4 MB application limit.
2026-10-20 Link the BOM table to its pinned hardware CSV source
    Originally researchanddesire/assembly-docs#24 (7e8e95d), which targeted staging. Documentation now publishes from main.
2026-10-20 Gate rig validation on firmware changes and post video evidence
    * Gate rig validation on firmware changes and post video evidence
    - PR target policy: firmware changes enter staging first unless they come
    from a fix/<issue> branch; every other change may target main directly.
    - PR firmware validation runs the build and Test Rig only when the firmware
    directory or the validation tooling changes; Build validation and Hardware
    validation pass without work otherwise. Title and body edits no longer
    start a second rig run.
    - Hardware evidence comments on the PR with each device's rig video, a GIF
    preview and the result, pass or fail, stored in the private hil-evidence
    bucket of Supabas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
2026-10-28 Read motor position, current and voltage through the OSSM HAT when present (#20)
    Motion stays on STEP/DIR with or without a HAT. When an OSSM HAT answers at boot, a reader task on core 0 takes the servo's full telemetry (alarm, current, speed, voltage, temperature, output, encoder position) 200 times a second and never writes to the servo. Motor readings come from it while it answers and fall back to the board's sensors for good after 20 failed reads.
    Also adds an ossm-alt build for the OSSM ALT Edition board (ESP32-S3, 8 MB flash, on-board RS-485, no speed knob), fixes streaming direction, and retries motion task starts while internal RAM is fragmented.
2026-10-28 Move software into software/firmware, scripts and dev
    - software/firmware/ is the PlatformIO project formerly in Software/.
    - software/scripts/ holds the release, capture, rig and cable rendering
    tooling, with requirements-cables.txt.
    - software/dev/ is reserved for local development services.
    - Workflows and docs follow the new paths; the pinned legacy 4 MB build
    keeps its own Software/ checkout.
2026-10-29 Command V2 HAT motion over guarded RS485
    Port the serial-position backend, cancellation ownership and independent UART timer stop to the current firmware layout. Preserve ALT telemetry-only STEP/DIR, the motor API and newer motion fixes.
    Promoted at the owner's explicit request without waiting for PR checks. Hardware qualification remains pending; release validation gates are unchanged.
2026-10-30 Restore shipping hardware assets and complete BOM source links (#21)
    * Restore shipping OSSM STEP models and PCB sources
    * Refresh the OHAI snapshot from the shipping BOM
    * Preserve purchase links and optional Ready-to-Play parts
    * Refresh OHAI snapshots with separate purchase sources
    * Clarify main-only BOM documentation sync
2026-11-09 Publish the OSSM build guides and link them from the assembly docs (#33)
    Add the latest edition of each stand, actuator, wiring and wired remote
    guide line from docs-builder as hardware/build-guides/<guide>-<major>.<minor>.pdf,
    with a README mapping each file to the version on its cover.
    Add a Build Guides page to the assembly docs, link it from the OSSM
    overview and the repository README, and mark PDFs as binary.
2026-11-09 Republish the OSSM build guides with the items box (#34)
    Replace six guides with the latest editions from docs-builder main
    (2ccc983): stand 1.0.14 and 0.1.1, actuator 1.1.11 and 1.0.16, wiring
    1.0.10 and wired remote 1.0.8. Stand 0.0.5 is unchanged.
2026-11-11 Publish the OSSM toy mounting guide (#39)
    * Publish the OSSM toy mounting guide
    Adds hardware/build-guides/toy-mounting-1.0.pdf (OSSM Toy Mounting Guide
    1.0.0): mounting a toy on the 24 mm threaded end effector with the
    flange base and flange ring, or the Vac-U-Lock adapter. Lists it on the
    Build Guides page with its cover thumbnail and in the folder README.
    * Update the toy mounting guide to 1.0.1
    Each mount is now locked by a lock nut, the ring choice is shown end on,
    the checks show the toy staying put, and a new step shows that only a
    toy with a Vac-U-Lock socket fits.
2026-11-11 Show the finished device as each build guide's thumbnail (#41)
2026-11-11 Toy Mounting Guide 1.0.2 (#42)
    * Toy Mounting Guide 1.0.2: ring fit at 45 degrees, air hole facing the reader, soft toys in the checks
    * Toy Mounting Guide 1.0.2: closer right/wrong pictures, partial slip-outs
2026-11-11 Add the actuator assembly jigs and Actuator Build Guide 1.1.12 (#43)
    Publish the bearing alignment jig and the 3.8 mm pulley spacer in hardware/cad/jigs with their print projects, and republish the actuator build guides (1.1.12 and 1.0.17), which now use them.
2026-11-11 Toy Mounting Guide 1.0.3 (#45)
    Replace hardware/build-guides/toy-mounting-1.0.pdf with edition 1.0.3: a new Part 2 ties the flange plates with paracord laced round their hooks, one step per hook, front and back. The Build Guides page description mentions paracord.
2026-11-14 Actuator Build Guide 1.1.13 (#48)
